igorpdsantos/alimentador-pet-iot/docs/estudos/chapeu/tabela_dem.md

| grão (mm) | variante | rodadas | ração (g) | carga no rotor/piso/escudo N (% do peso) | carga no chapéu N | torque mediano kgf·cm (faixa) | torque p90 | tempo acima de 1,8 kgf·cm | g/volta (faixa) |
|---|---|---|---|---|---|---|---|---|---|
| 10 | sem chapéu | 2 | 872 | 5.7 (67 %) | 0.0 | 2.91 (2.85–2.97) | 4.07 | 94 % | 47.8 (45.9–49.6) |
| 10 | cone Ø60 | 2 | 794 | 1.3 (17 %) | 4.6 | 0.40 (0.38–0.43) | 1.15 | 3 % | 43.2 (42.2–44.3) |
| 10 | cone Ø50 | 2 | 830 | 2.9 (36 %) | 2.9 | 1.62 (1.42–1.82) | 2.86 | 43 % | 48.3 (46.6–50.1) |
| 10 | telhado (aresta +5) | 2 | 708 | 1.1 (16 %) | 3.7 | 1.26 (1.23–1.29) | 2.13 | 23 % | 46.4 (45.5–47.4) |
| 10 | telhado (aresta +15) | 2 | 651 | 0.9 (13 %) | 4.3 | 0.93 (0.90–0.97) | 1.83 | 12 % | 44.7 (42.6–46.9) |
| 10 | telhado (aresta −10) | 2 | 793 | 3.0 (38 %) | 2.7 | 1.68 (1.60–1.76) | 2.66 | 46 % | 46.0 (44.5–47.6) |
| 10 | telhado baixo (11 mm) | 2 | 731 | 1.7 (24 %) | 3.7 | 0.72 (0.64–0.80) | 1.77 | 11 % | 44.2 (43.6–44.8) |
| 10 | telhado alto (40 mm) | 2 | 704 | 1.7 (25 %) | 3.4 | 1.36 (1.33–1.39) | 2.27 | 27 % | 47.2 (46.7–47.7) |
| 10 | bloco reto, aresta 25 mm | 2 | 707 | 1.6 (23 %) | 3.2 | 1.70 (1.59–1.82) | 2.81 | 46 % | 46.6 (44.9–48.3) |
| 10 | bloco reto, aresta 40 mm | 2 | 696 | 1.6 (24 %) | 3.5 | 2.04 (1.83–2.25) | 3.19 | 69 % | 46.6 (46.4–46.9) |
| 10 | P10 final: cumeeira 45°, aresta 40 mm | 2 | 700 | 1.6 (24 %) | 3.5 | 1.32 (1.24–1.40) | 2.16 | 22 % | 47.4 (46.9–47.9) |
| 20 | sem chapéu | 3 | 779 | 5.1 (67 %) | 0.0 | 2.63 (0.66–3.81) | 6.42 | 63 % | 12.7 (8.7–17.0) |
| 20 | cone Ø60 | 3 | 640 | 0.1 (2 %) | 5.4 | 0.00 (0.00–0.00) | 0.05 | 1 % | 3.5 (0.8–4.8) |
| 20 | cone Ø50 | 3 | 721 | 2.0 (28 %) | 4.0 | 2.64 (1.33–4.88) | 6.51 | 60 % | 17.5 (12.7–22.2) |
| 20 | telhado (aresta +5) | 3 | 622 | 1.9 (31 %) | 3.0 | 1.54 (1.38–1.65) | 5.11 | 46 % | 13.5 (10.0–15.2) |
| 20 | telhado (aresta +15) | 3 | 561 | 0.5 (8 %) | 4.6 | 0.44 (0.30–0.56) | 1.28 | 7 % | 6.4 (4.5–9.0) |
| 20 | telhado (aresta −10) | 3 | 699 | 3.0 (44 %) | 2.6 | 1.80 (1.67–1.91) | 5.42 | 51 % | 13.3 (10.4–14.8) |
| 20 | telhado baixo (11 mm) | 3 | 651 | 1.8 (28 %) | 3.2 | 0.36 (0.17–0.71) | 1.10 | 7 % | 7.9 (2.4–14.1) |
| 20 | telhado alto (40 mm) | 3 | 599 | 1.5 (25 %) | 3.3 | 1.16 (0.39–2.13) | 5.68 | 40 % | 19.3 (17.4–23.0) |
| 20 | bloco reto, aresta 25 mm | 4 | 634 | 1.7 (27 %) | 3.6 | 0.75 (0.19–1.86) | 2.25 | 21 % | 13.6 (7.5–21.0) |
| 20 | bloco reto, aresta 40 mm | 4 | 606 | 2.1 (36 %) | 3.4 | 1.49 (0.72–2.32) | 6.24 | 44 % | 21.8 (18.8–24.1) |
| 20 | P10 final: cumeeira 45°, aresta 40 mm | 4 | 605 | 2.1 (35 %) | 3.1 | 1.74 (0.88–2.72) | 5.08 | 47 % | 17.8 (12.5–25.7) |
| 20 | P10 aresta a 40 mm, +15 | 2 | 516 | 0.5 (10 %) | 4.1 | 0.69 (0.25–1.13) | 3.73 | 27 % | 8.4 (6.1–10.7) |
