igorpdsantos/alimentador-pet-iot/cad/historico/v2/renders/v2/corte_X0.png

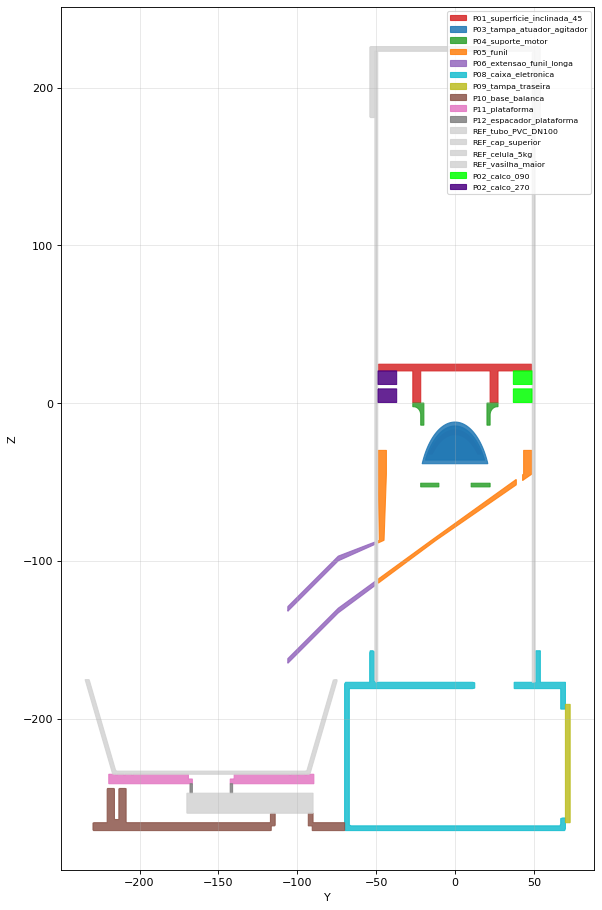
cad/historico/v2/renders/v2/corte_X0.png
