igorpdsantos/alimentador-pet-iot/cad/historico/v2/renders/v2/corte_Y0.png

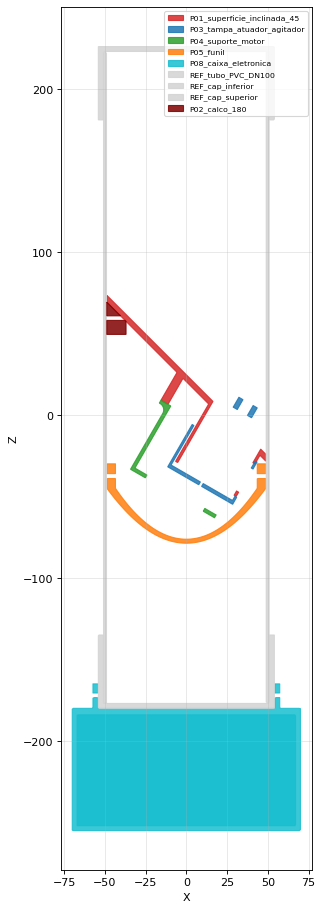
cad/historico/v2/renders/v2/corte_Y0.png
