igorpdsantos/alimentador-pet-iot/cad/historico/v2/renders/v2/render_iso.png

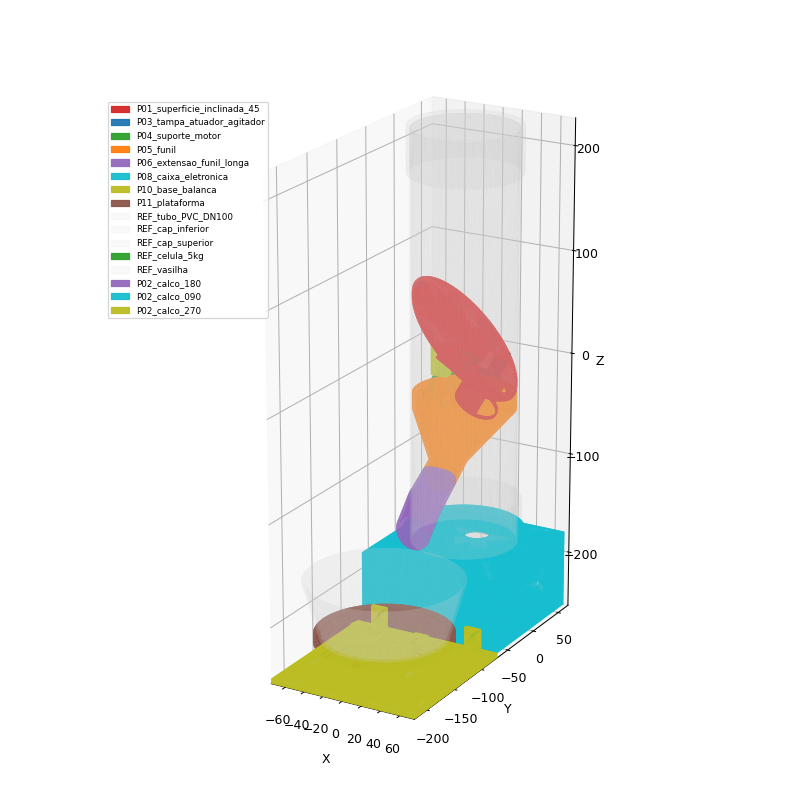
cad/historico/v2/renders/v2/render_iso.png
