igorpdsantos/alimentador-pet-iot/cad/historico/v2/renders/v2/render_side.png

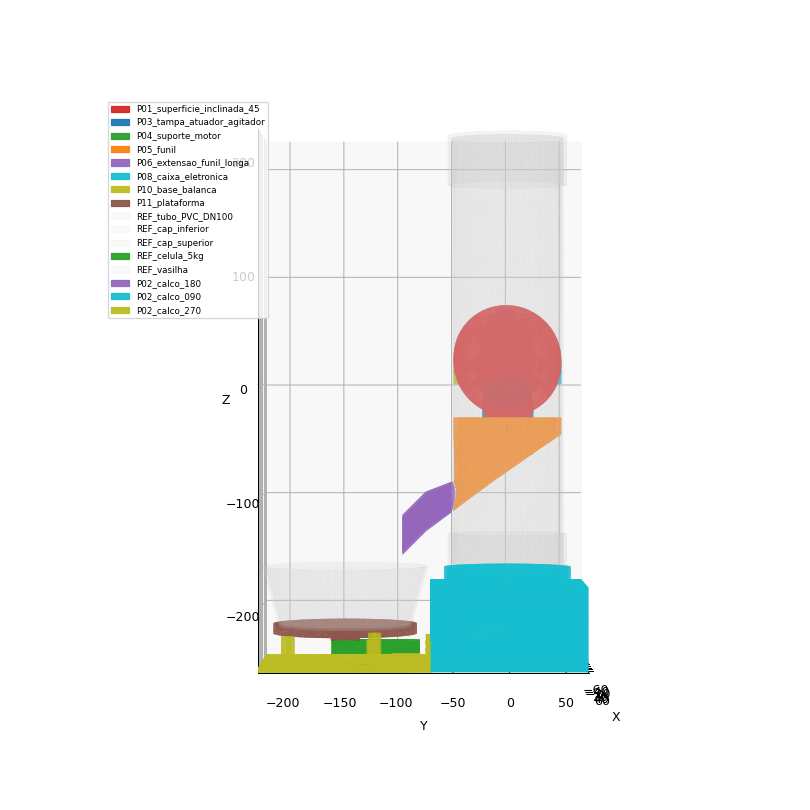
cad/historico/v2/renders/v2/render_side.png
