igorpdsantos/alimentador-pet-iot/cad/historico/v2/renders/v2_mecanismo/render_side.png

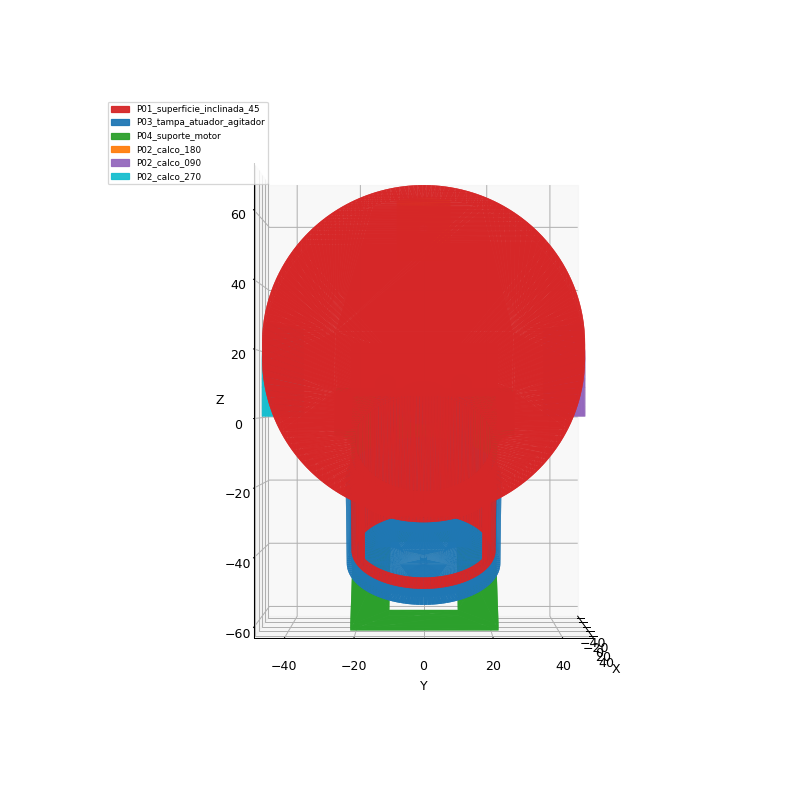
cad/historico/v2/renders/v2_mecanismo/render_side.png
