igorpdsantos/alimentador-pet-iot/cad/historico/v2/renders/v2_tampa/render_iso.png

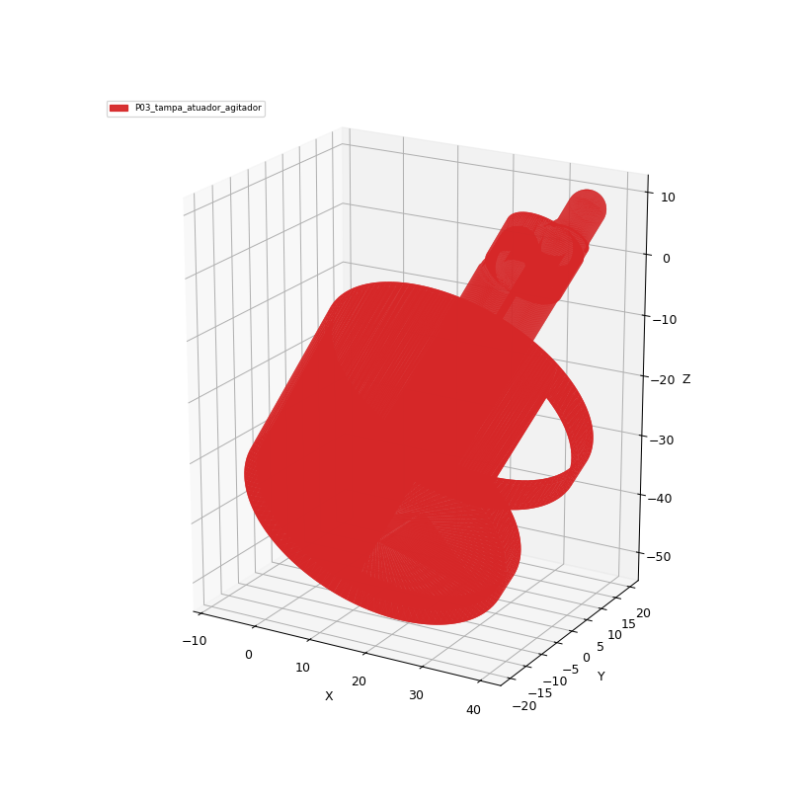
cad/historico/v2/renders/v2_tampa/render_iso.png
