igorpdsantos/alimentador-pet-iot/cad/renders/v3/chapeu/corte_Y0.png

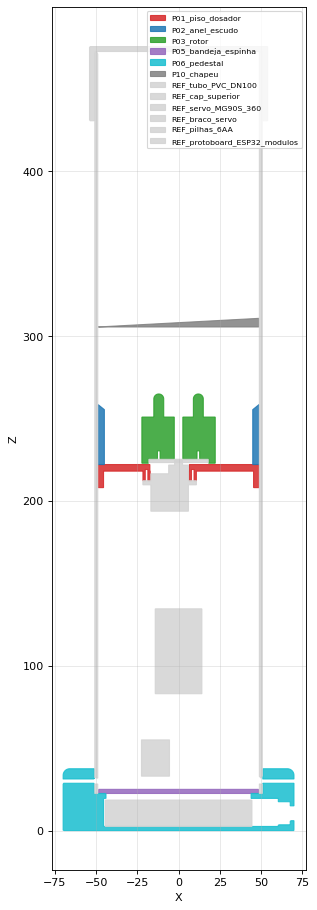
cad/renders/v3/chapeu/corte_Y0.png
