igorpdsantos/alimentador-pet-iot/cad/renders/v3/chapeu/render_iso.png

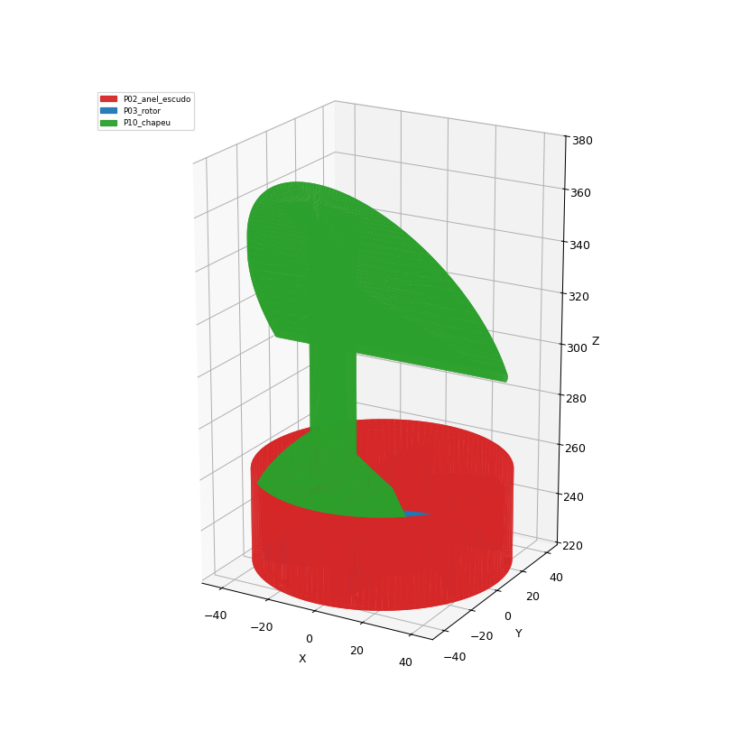
cad/renders/v3/chapeu/render_iso.png
