igorpdsantos/alimentador-pet-iot/cad/renders/v3/chapeu/render_top.png

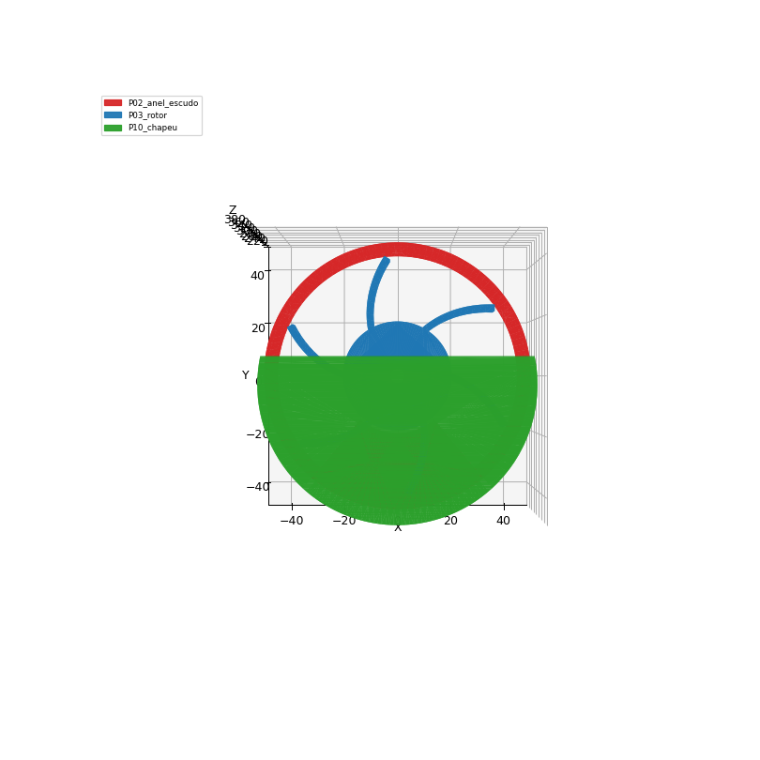
cad/renders/v3/chapeu/render_top.png
