igorpdsantos/alimentador-pet-iot/cad/renders/v3/corte_X0.png

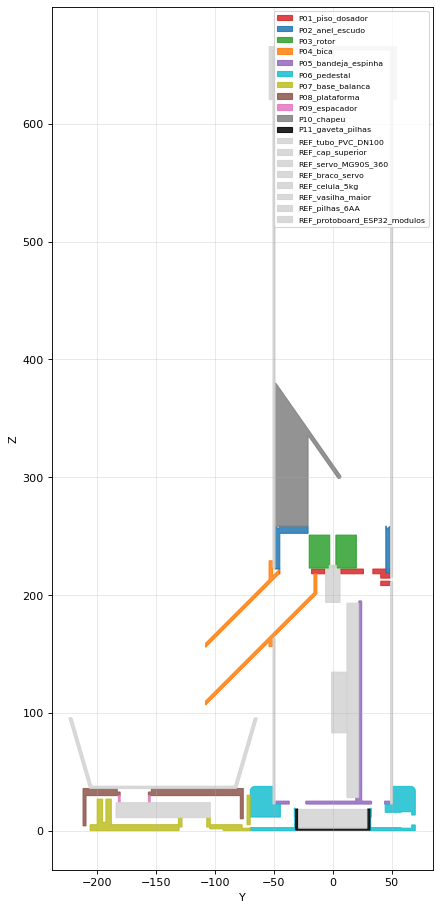
cad/renders/v3/corte_X0.png
