igorpdsantos/alimentador-pet-iot/cad/renders/v3/gaveta/ped/render_iso.png

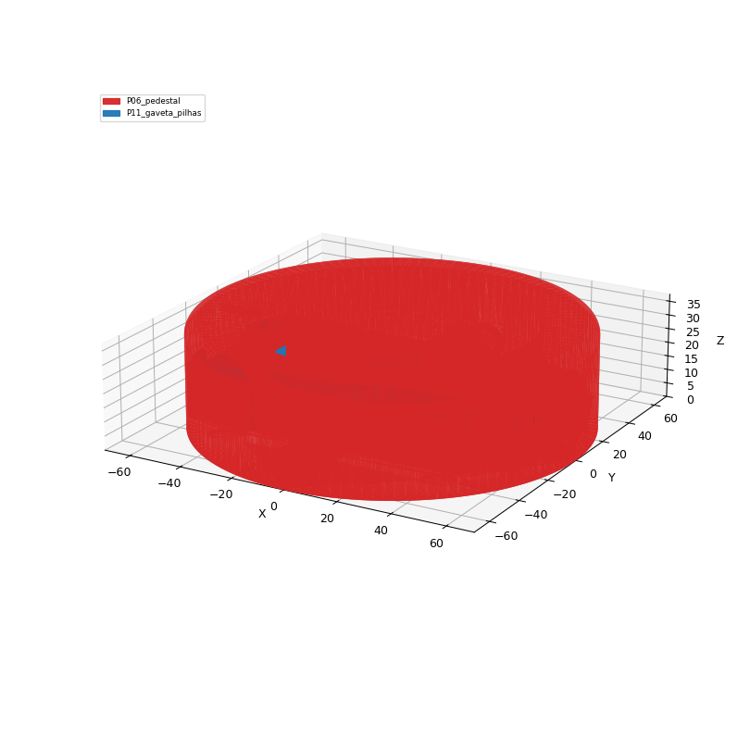
cad/renders/v3/gaveta/ped/render_iso.png
