igorpdsantos/alimentador-pet-iot/cad/renders/v3/gaveta/render_top.png

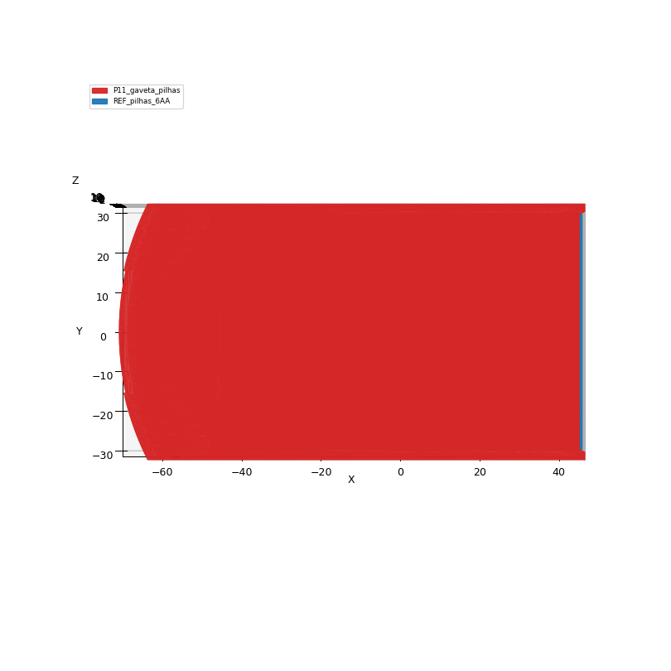
cad/renders/v3/gaveta/render_top.png
