igorpdsantos/alimentador-pet-iot/cad/renders/v3/render_front.png

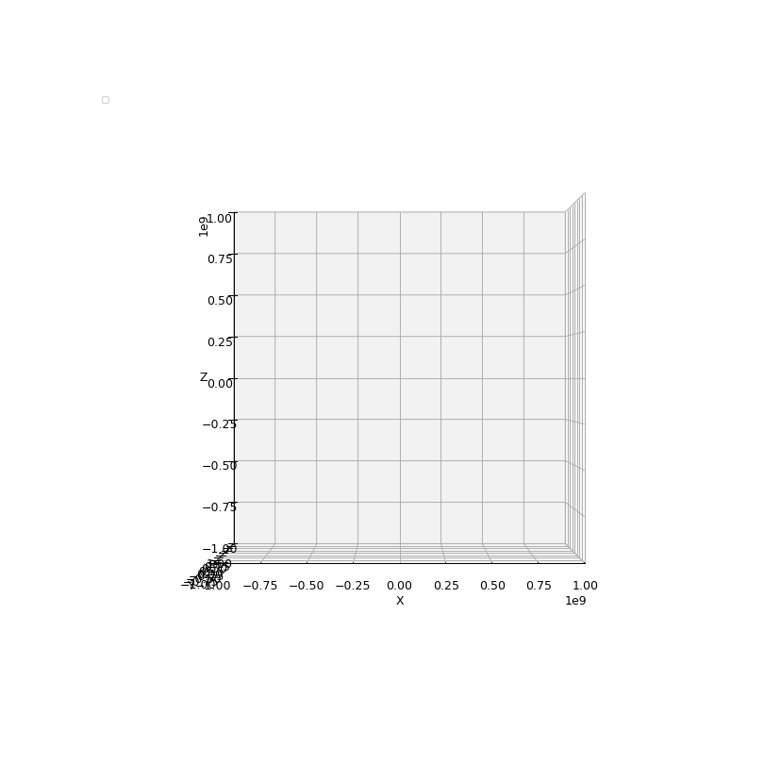
cad/renders/v3/render_front.png
