igorpdsantos/alimentador-pet-iot/cad/renders/v3/render_iso.png

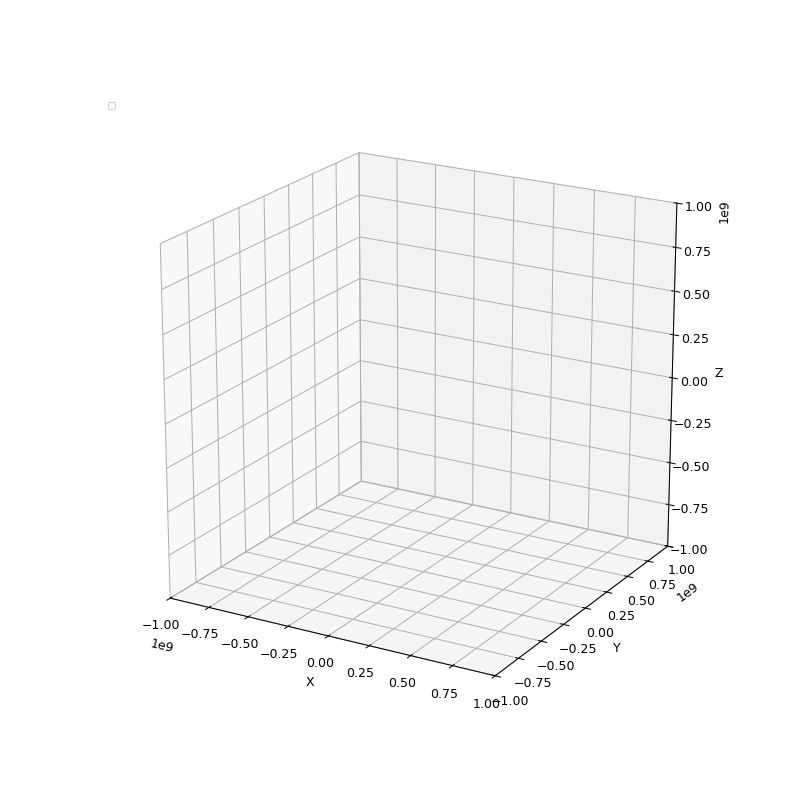
cad/renders/v3/render_iso.png
