igorpdsantos/alimentador-pet-iot/cad/renders/v3/render_side.png

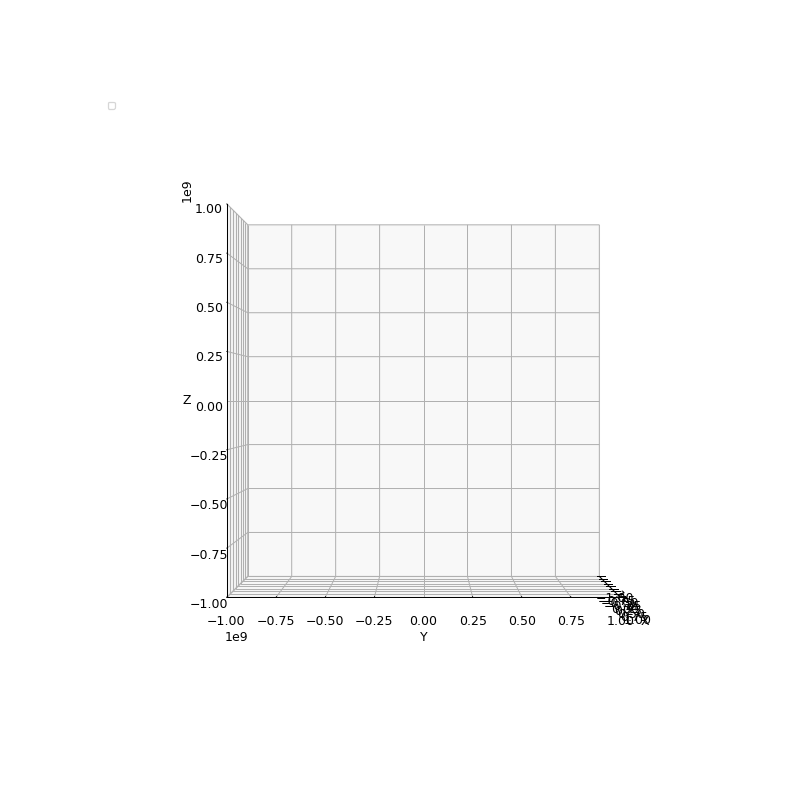
cad/renders/v3/render_side.png
