igorpdsantos/alimentador-pet-iot/cad/renders/v3/render_top.png

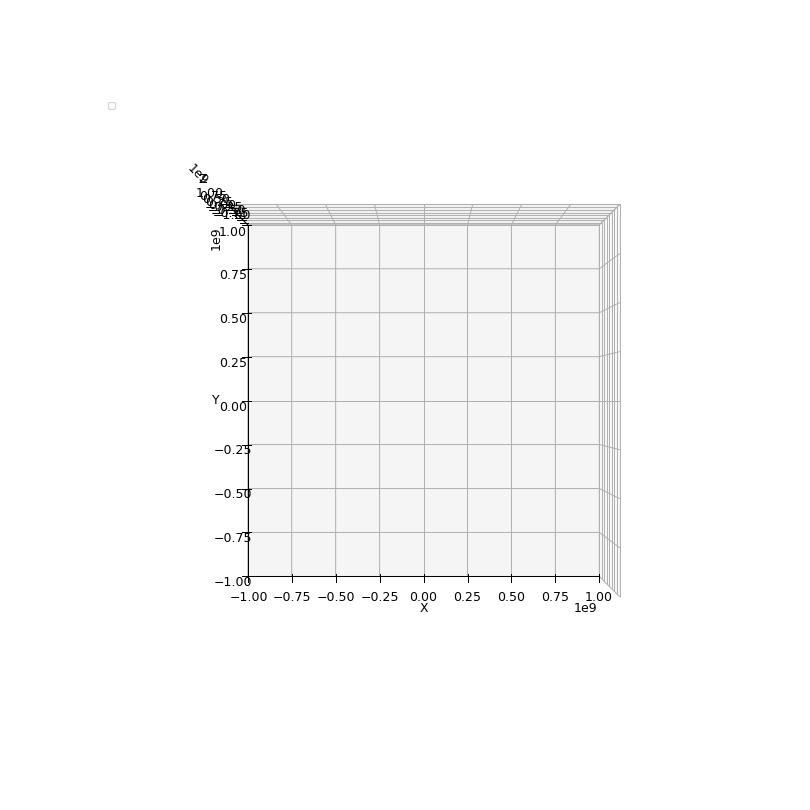
cad/renders/v3/render_top.png
