igorpdsantos/alimentador-pet-iot/docs/estudos/chapeu/dem_comparacao.png

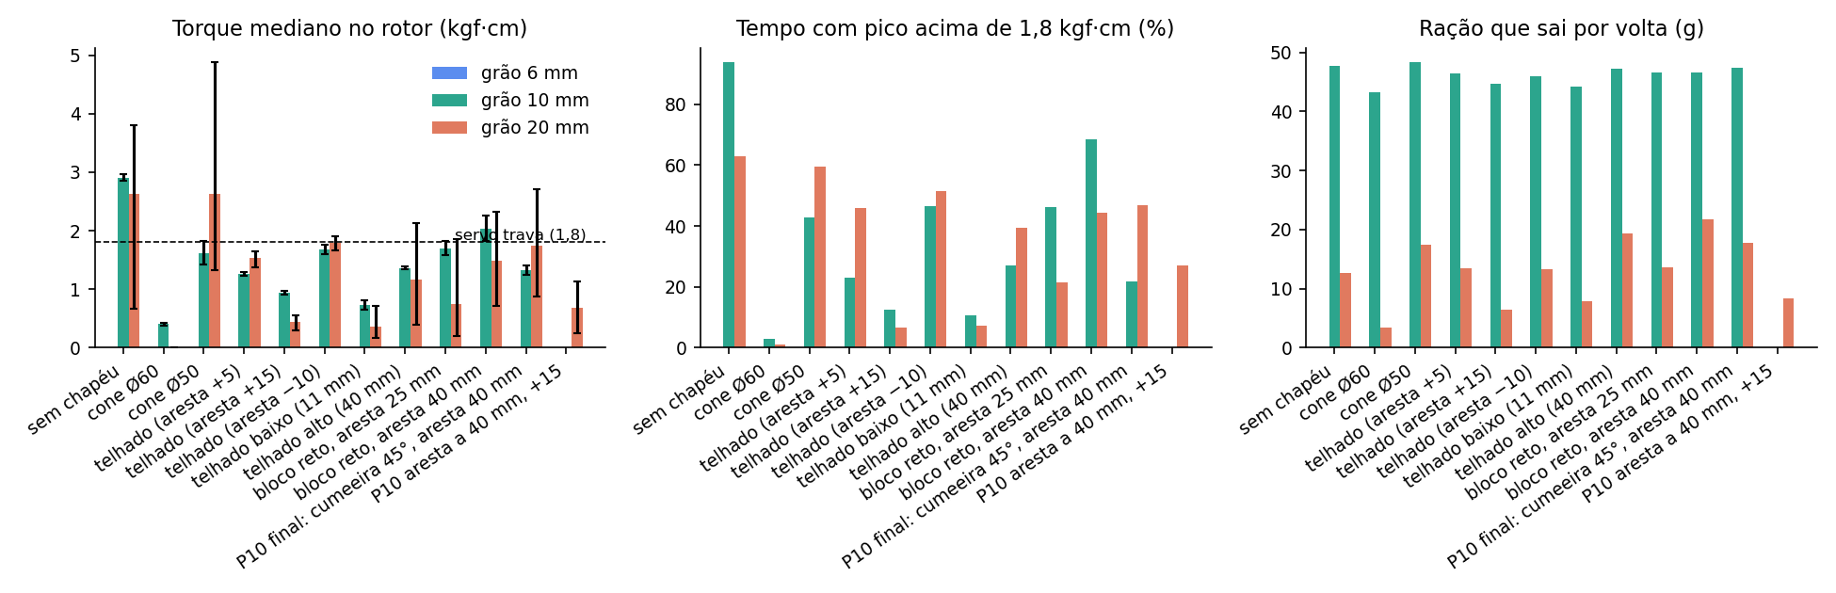
docs/estudos/chapeu/dem_comparacao.png
