igorpdsantos/alimentador-pet-iot/docs/estudos/chapeu/dem_serie_10mm.png

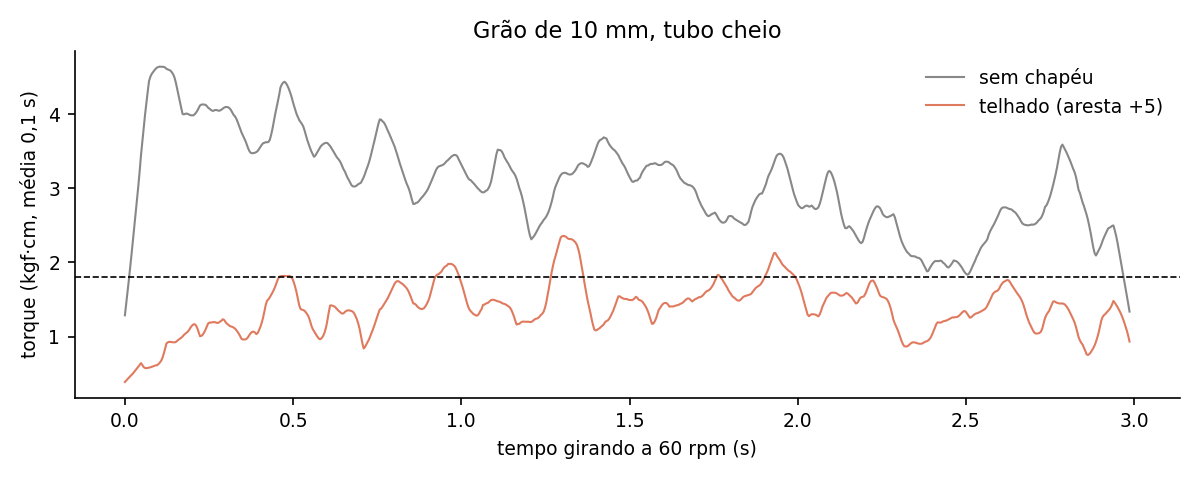
docs/estudos/chapeu/dem_serie_10mm.png
