igorpdsantos/alimentador-pet-iot/docs/imagens/01_geral.png

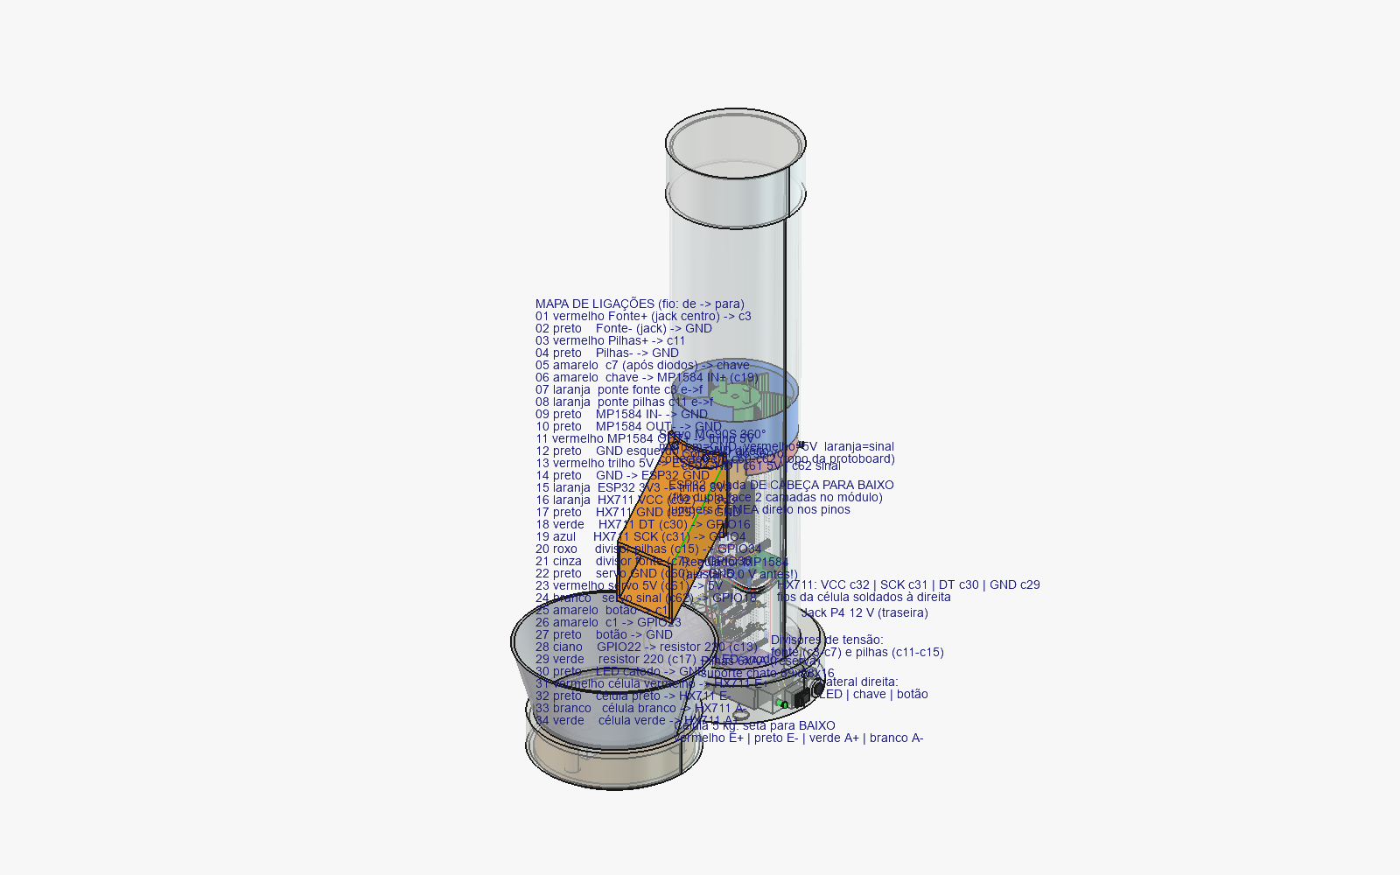
docs/imagens/01_geral.png
