igorpdsantos/alimentador-pet-iot/docs/imagens/02_protoboard_frente.png

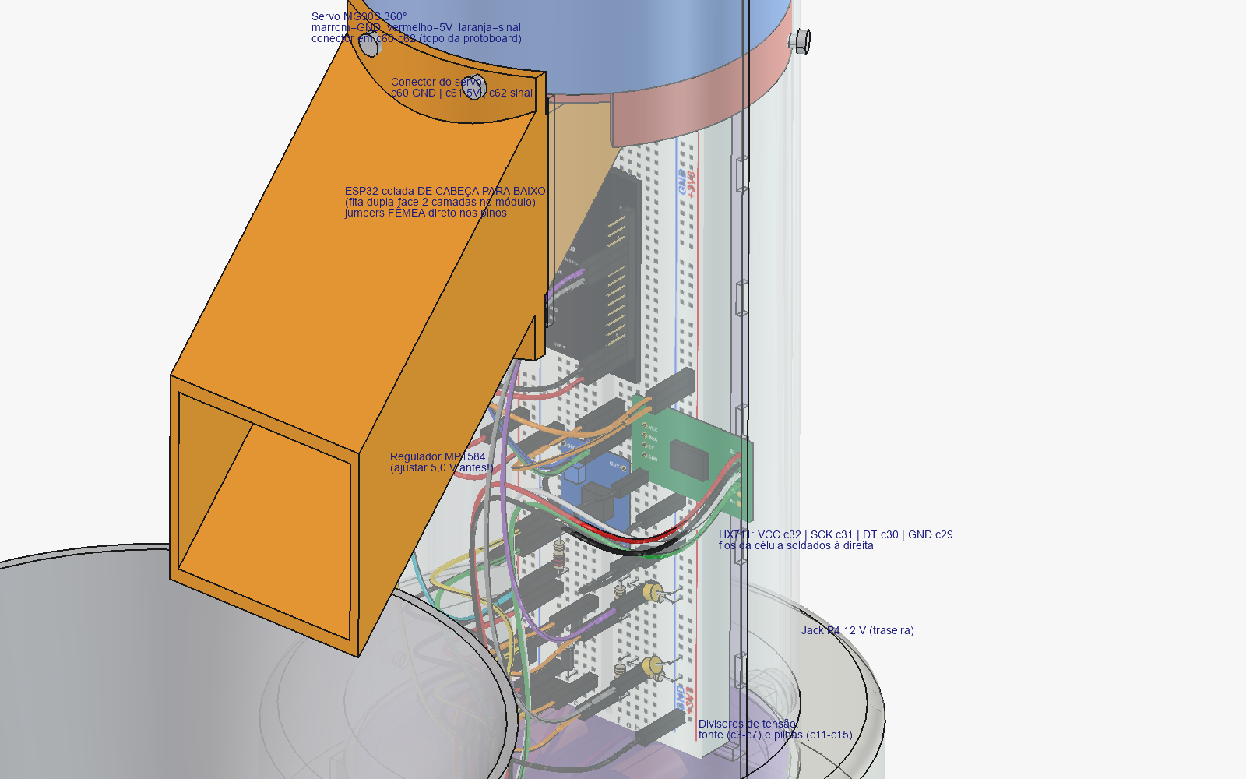
docs/imagens/02_protoboard_frente.png
