igorpdsantos/alimentador-pet-iot/docs/imagens/03_esp32_pinos.png

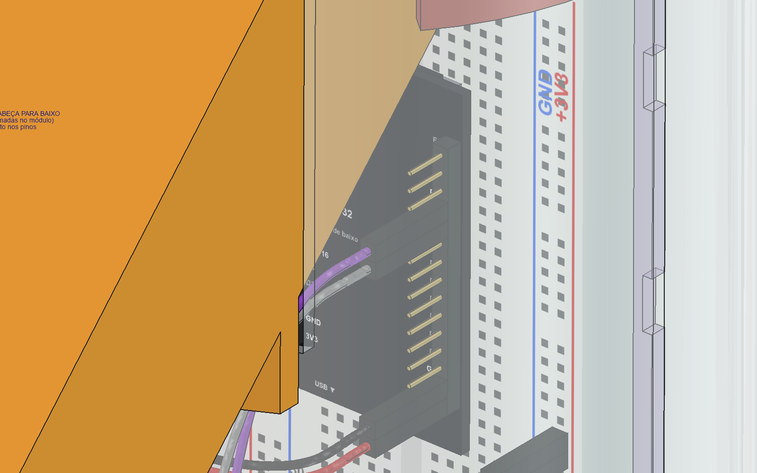
docs/imagens/03_esp32_pinos.png
