igorpdsantos/alimentador-pet-iot/docs/imagens/04_pedestal.png

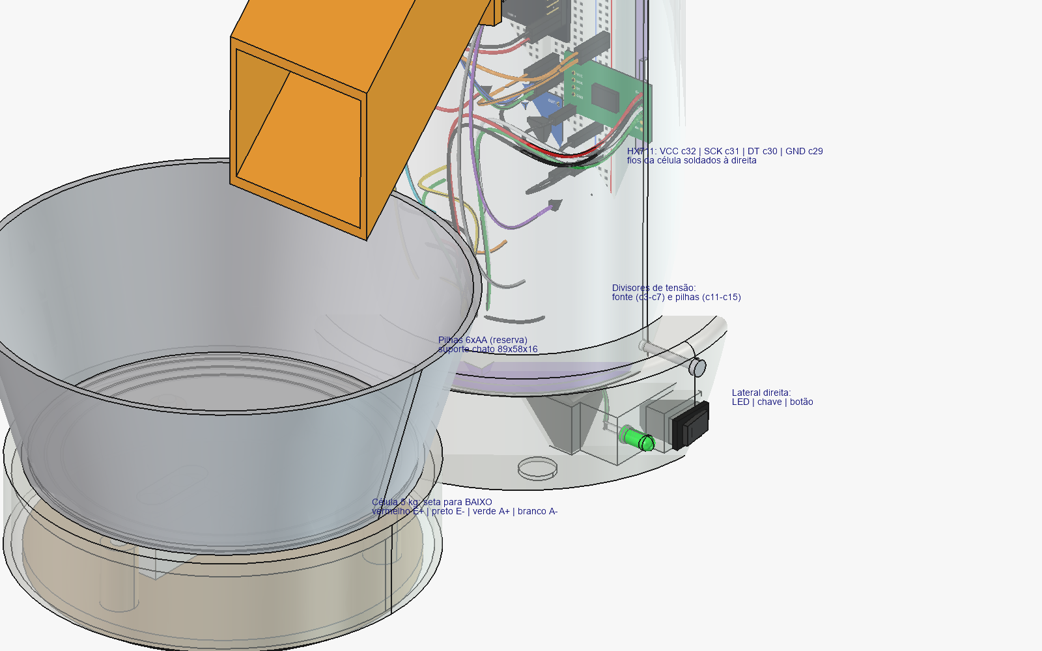
docs/imagens/04_pedestal.png
