igorpdsantos/alimentador-pet-iot/docs/imagens/05_balanca.png

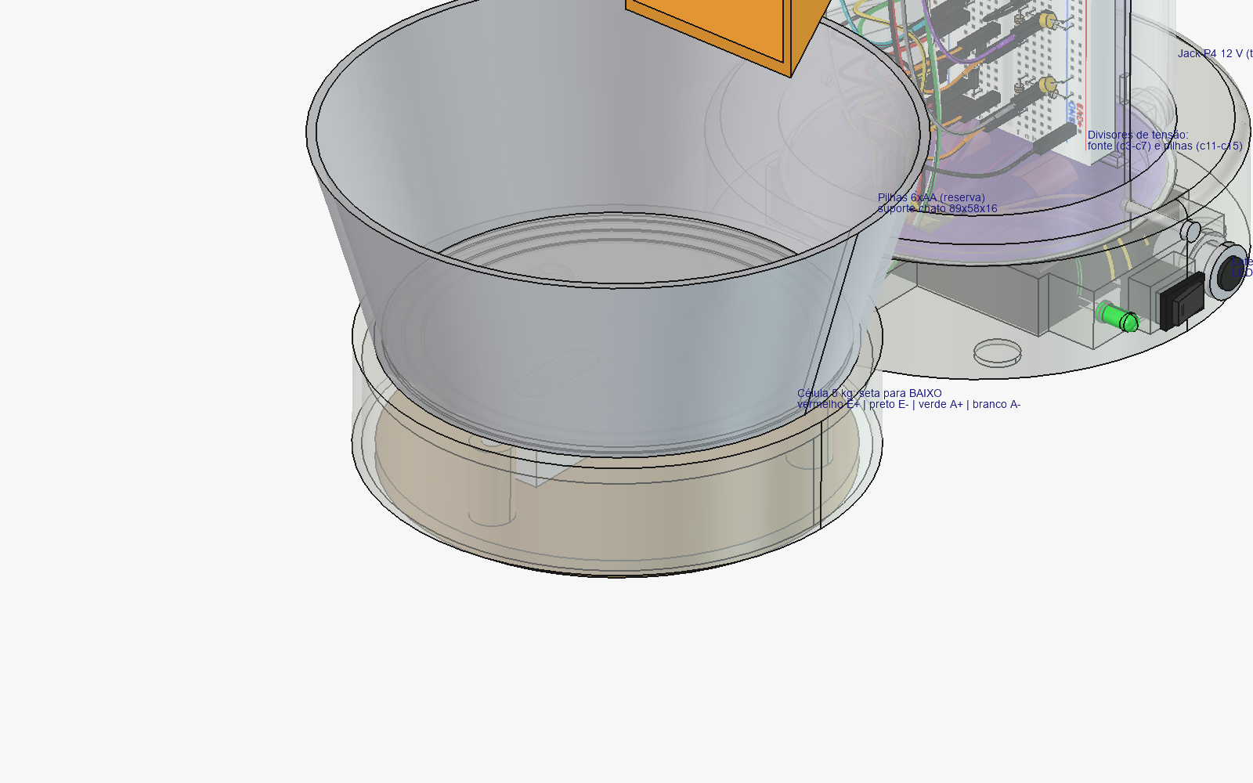
docs/imagens/05_balanca.png
