igorpdsantos/alimentador-pet-iot/docs/imagens/06_servo_cartucho.png

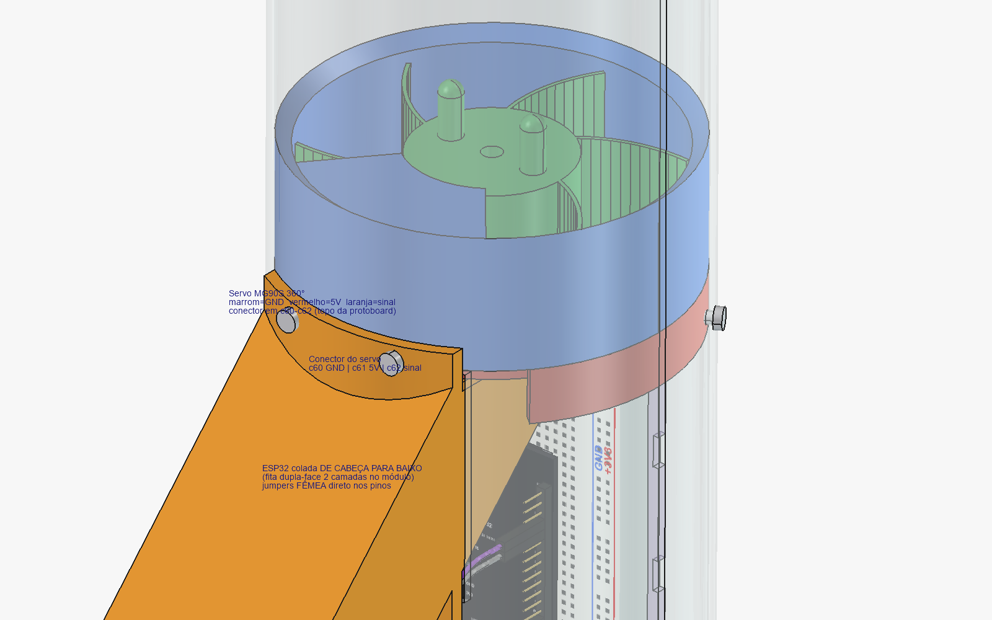
docs/imagens/06_servo_cartucho.png
