igorpdsantos/alimentador-pet-iot/site/img/balanca.png

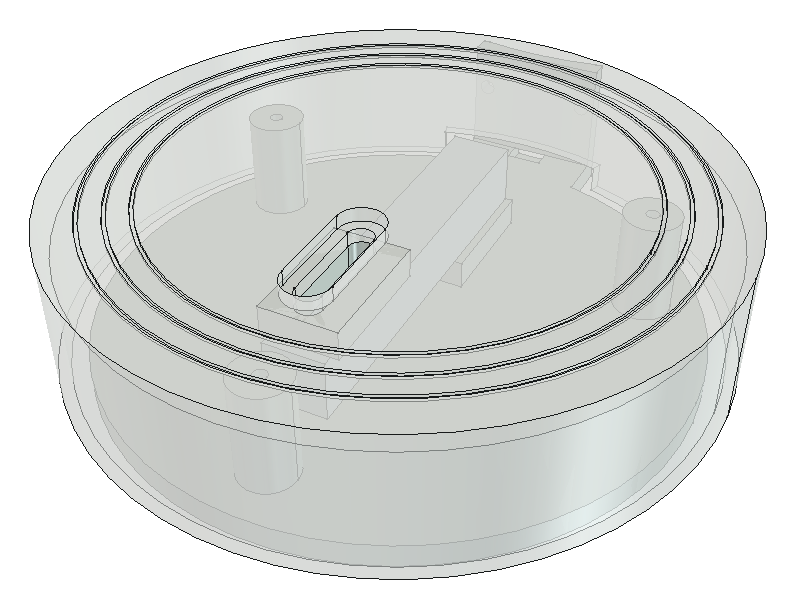
site/img/balanca.png
