igorpdsantos/alimentador-pet-iot/site/img/cartucho.png

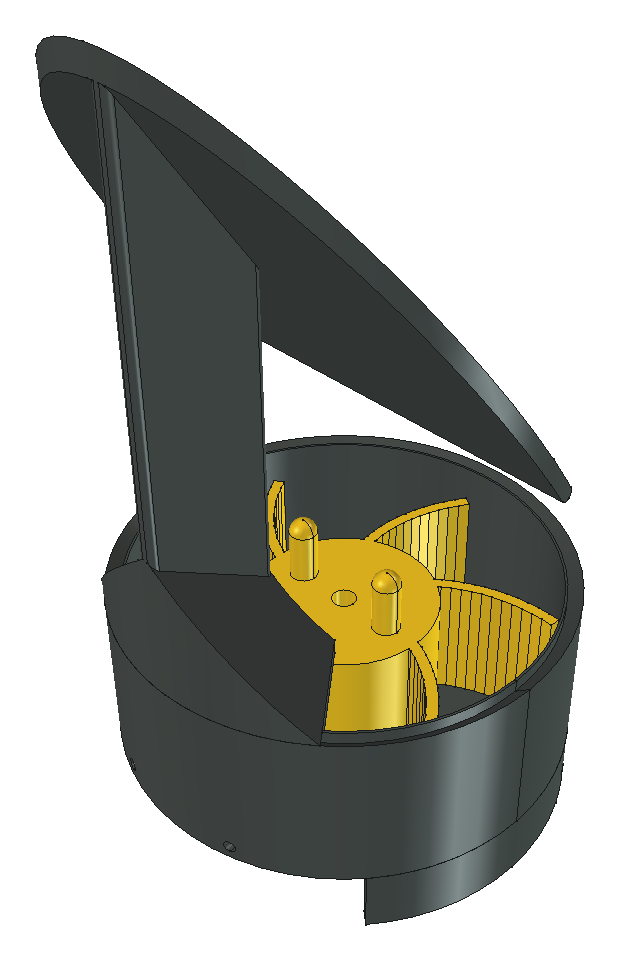
site/img/cartucho.png
