igorpdsantos/alimentador-pet-iot/site/img/comp/botao.png

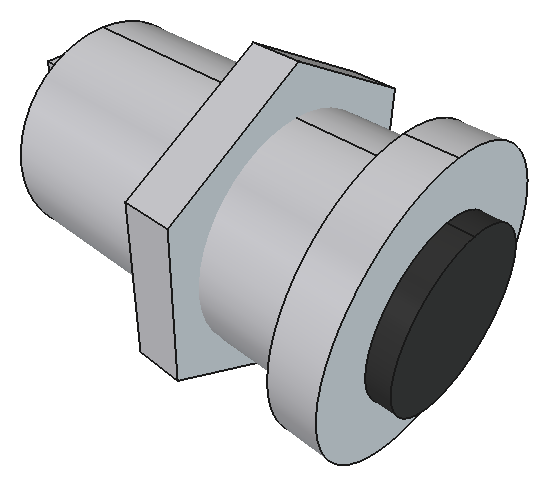
site/img/comp/botao.png
