igorpdsantos/alimentador-pet-iot/site/img/comp/cap.png

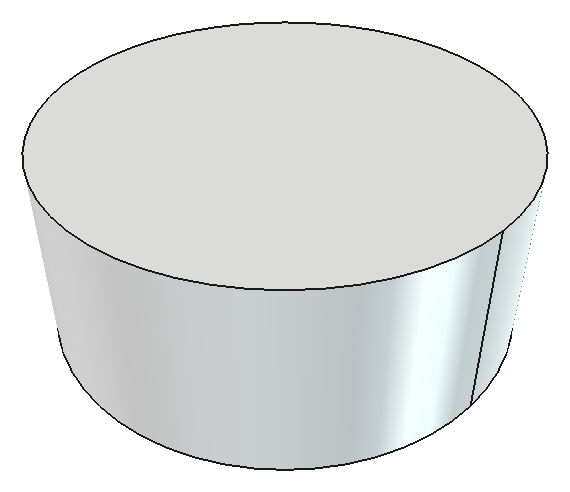
site/img/comp/cap.png
