igorpdsantos/alimentador-pet-iot/site/img/comp/cap_ceramico.png

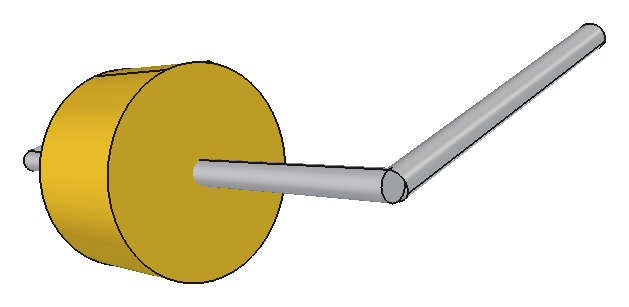
site/img/comp/cap_ceramico.png
