igorpdsantos/alimentador-pet-iot/site/img/comp/cap_eletrolitico.png

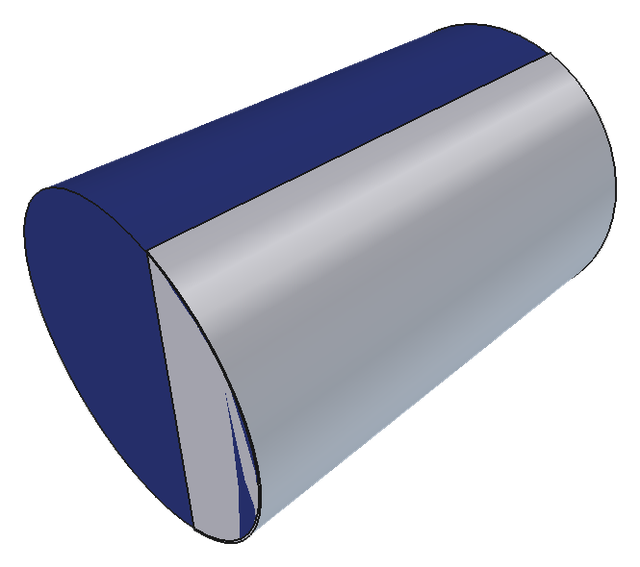
site/img/comp/cap_eletrolitico.png
