igorpdsantos/alimentador-pet-iot/site/img/comp/celula.png

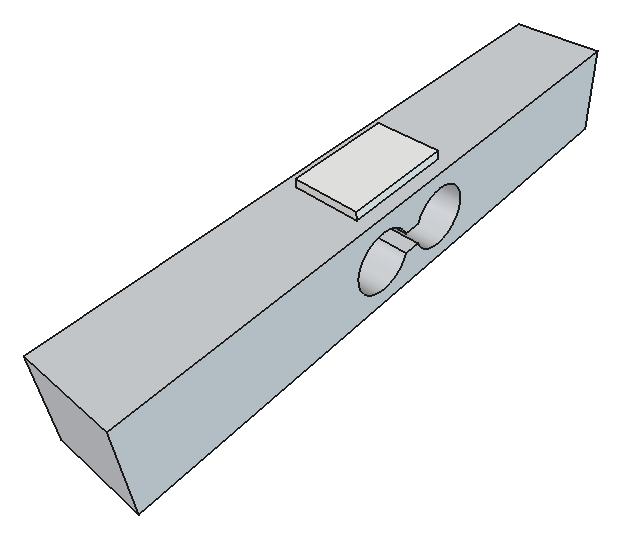
site/img/comp/celula.png
