igorpdsantos/alimentador-pet-iot/site/img/comp/chave.png

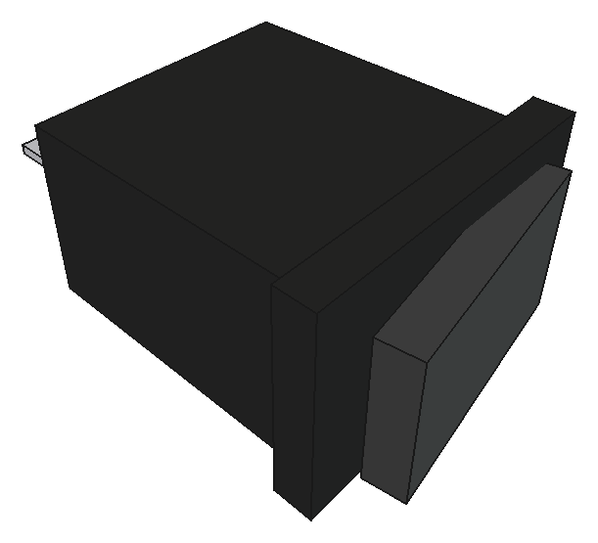
site/img/comp/chave.png
