igorpdsantos/alimentador-pet-iot/site/img/comp/diodo.png

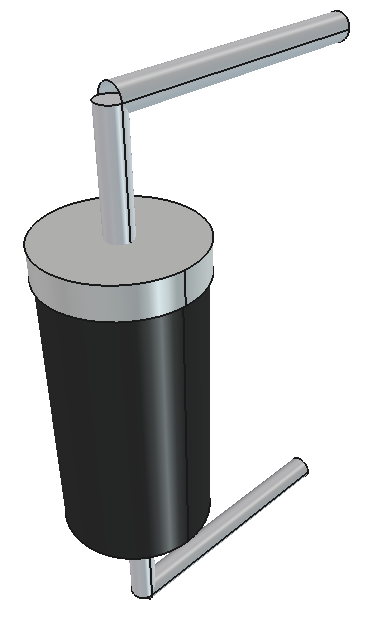
site/img/comp/diodo.png
