igorpdsantos/alimentador-pet-iot/site/img/comp/esp32.png

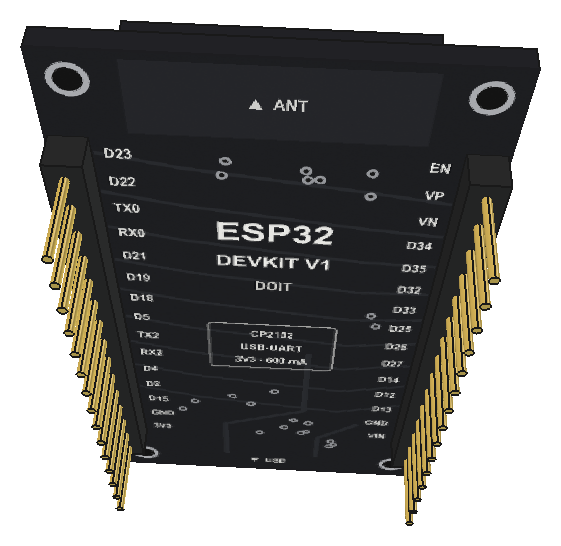
site/img/comp/esp32.png
