igorpdsantos/alimentador-pet-iot/site/img/comp/hx711.png

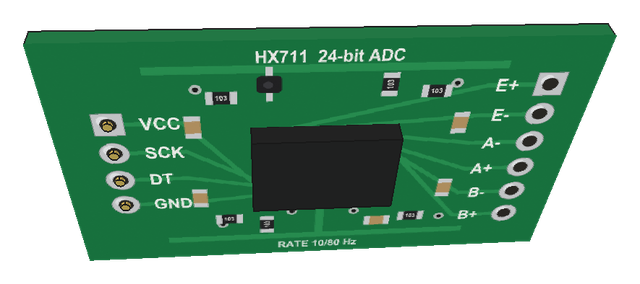
site/img/comp/hx711.png
