igorpdsantos/alimentador-pet-iot/site/img/comp/imas.png

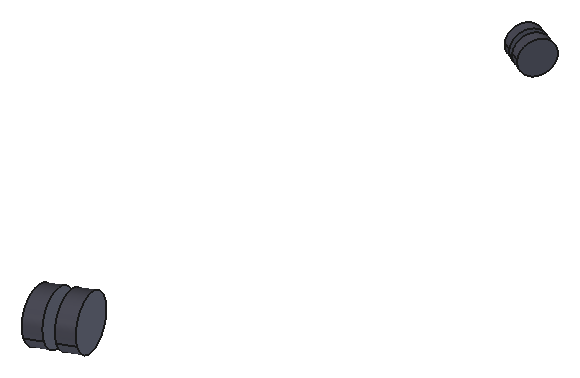
site/img/comp/imas.png
