igorpdsantos/alimentador-pet-iot/site/img/comp/jack.png

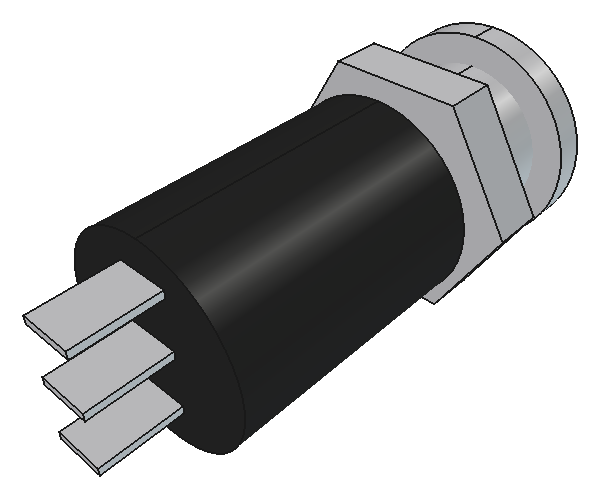
site/img/comp/jack.png
