igorpdsantos/alimentador-pet-iot/site/img/comp/led.png

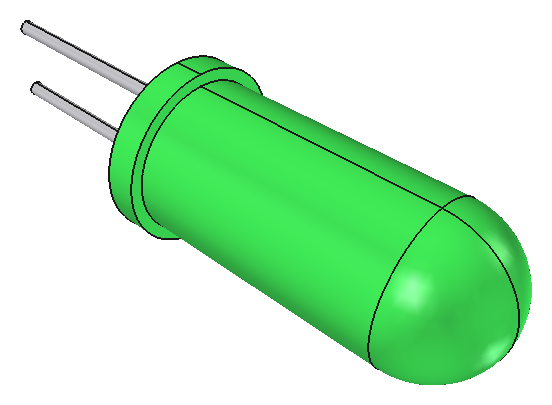
site/img/comp/led.png
