igorpdsantos/alimentador-pet-iot/site/img/comp/m3x8.png

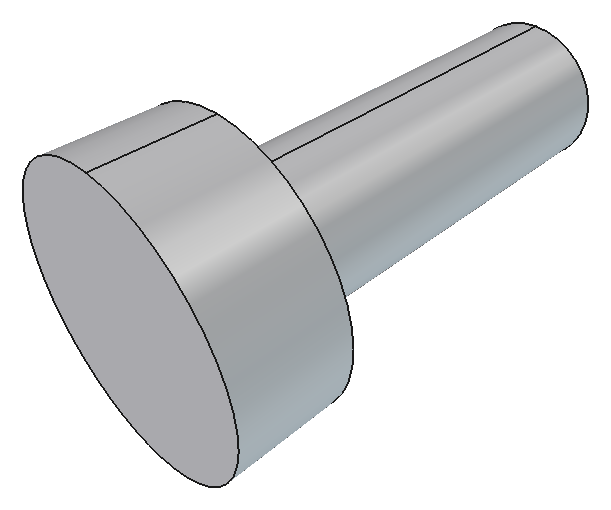
site/img/comp/m3x8.png
