igorpdsantos/alimentador-pet-iot/site/img/comp/m3x10.png

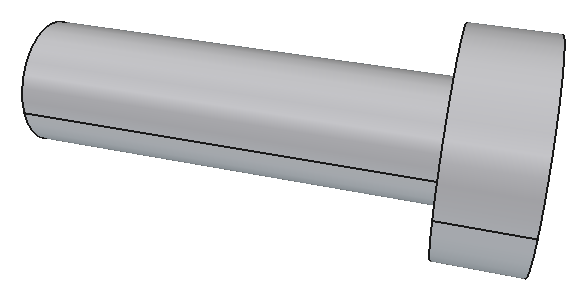
site/img/comp/m3x10.png
