igorpdsantos/alimentador-pet-iot/site/img/comp/m3x12.png

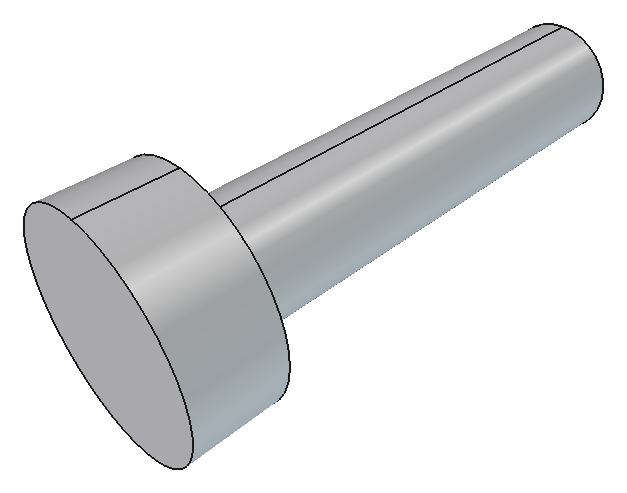
site/img/comp/m3x12.png
