igorpdsantos/alimentador-pet-iot/site/img/comp/m3x20.png

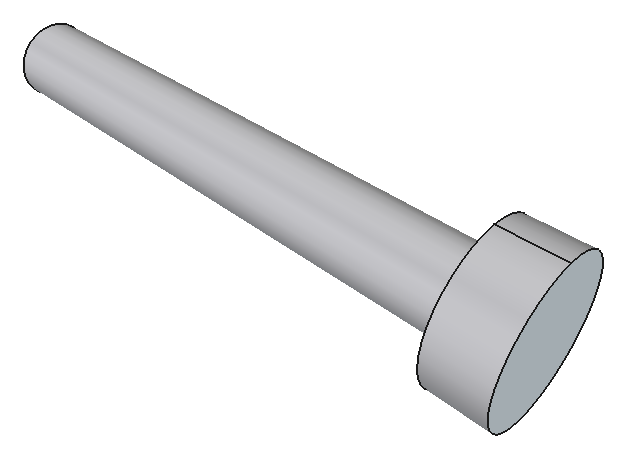
site/img/comp/m3x20.png
