igorpdsantos/alimentador-pet-iot/site/img/comp/m4x16.png

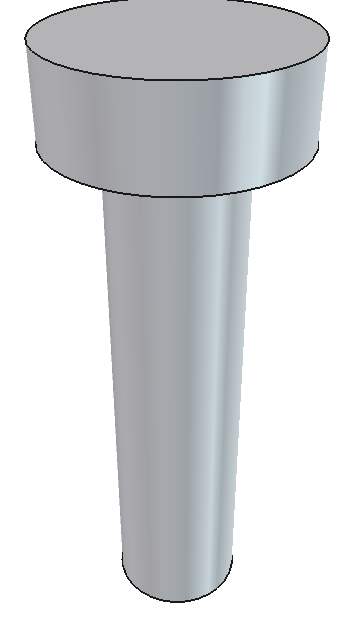
site/img/comp/m4x16.png
