igorpdsantos/alimentador-pet-iot/site/img/comp/m5x16.png

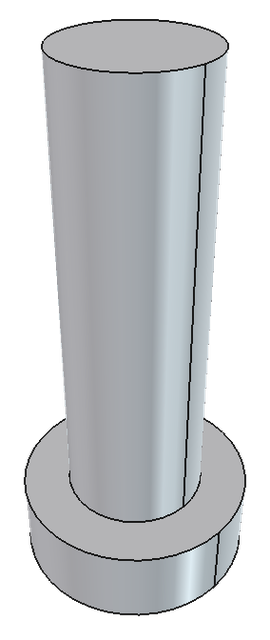
site/img/comp/m5x16.png
