igorpdsantos/alimentador-pet-iot/site/img/comp/mp1584.png

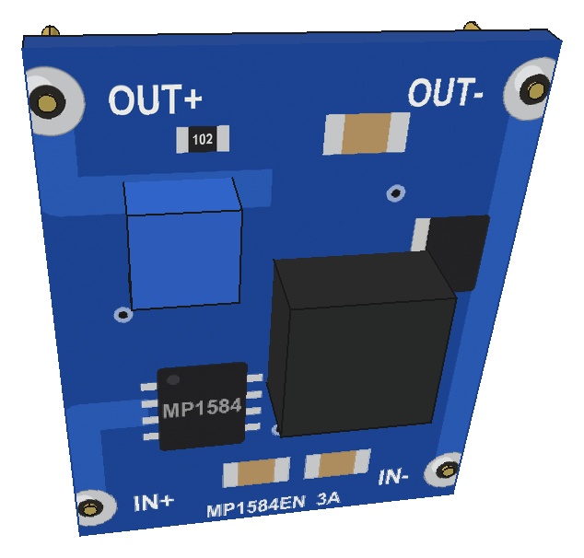
site/img/comp/mp1584.png
