igorpdsantos/alimentador-pet-iot/site/img/comp/pilhas.png

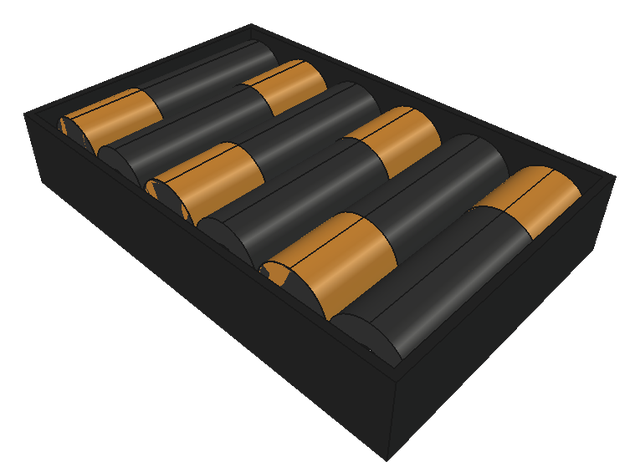
site/img/comp/pilhas.png
