igorpdsantos/alimentador-pet-iot/site/img/comp/protoboard.png

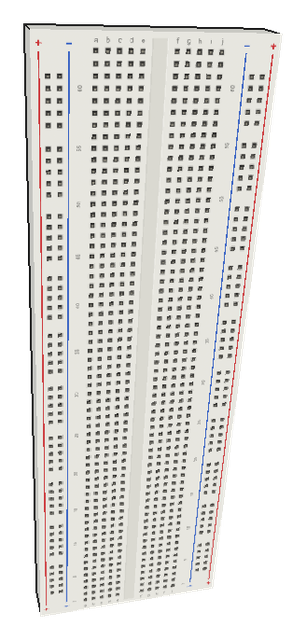
site/img/comp/protoboard.png
