igorpdsantos/alimentador-pet-iot/site/img/comp/resistor.png

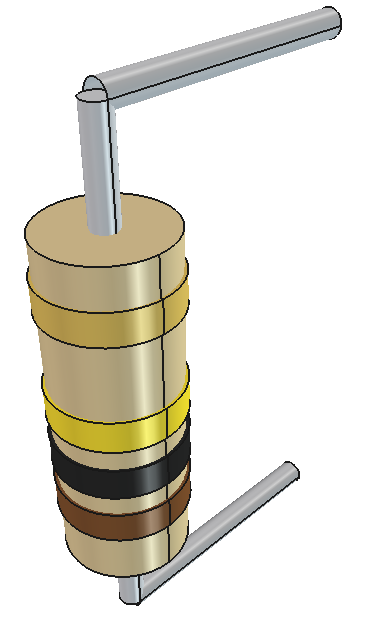
site/img/comp/resistor.png
