igorpdsantos/alimentador-pet-iot/site/img/comp/servo.png

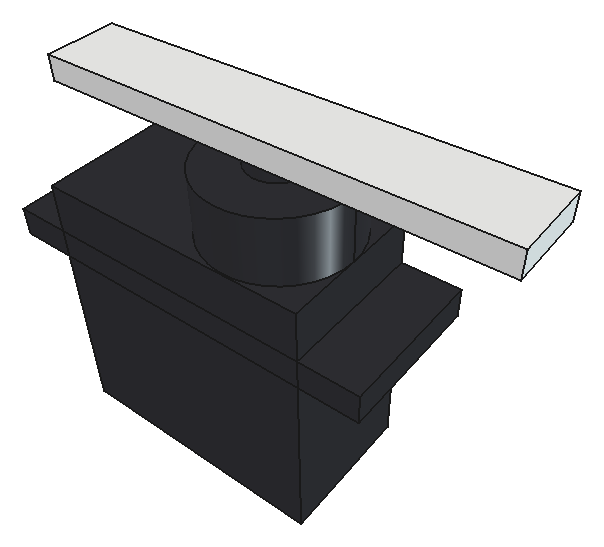
site/img/comp/servo.png
