igorpdsantos/alimentador-pet-iot/site/img/comp/tubo.png

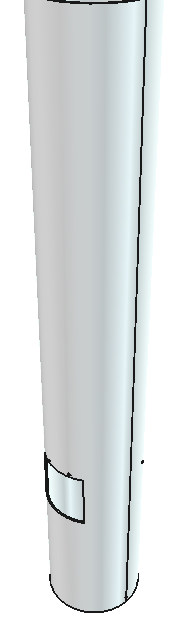
site/img/comp/tubo.png
