igorpdsantos/alimentador-pet-iot/site/img/comp/vasilha.png

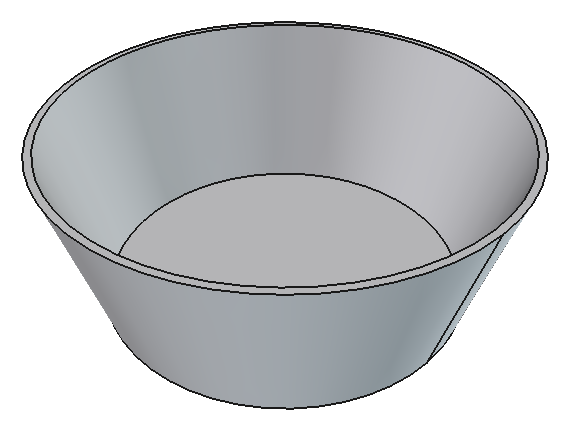
site/img/comp/vasilha.png
