igorpdsantos/alimentador-pet-iot/site/img/eletronica.png

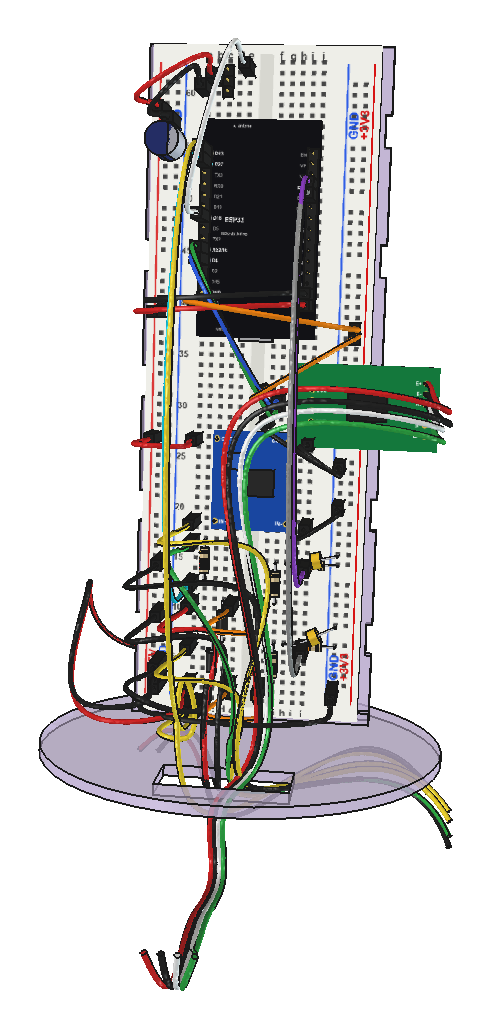
site/img/eletronica.png
