igorpdsantos/alimentador-pet-iot/site/img/pecas/P01_piso_dosador.png

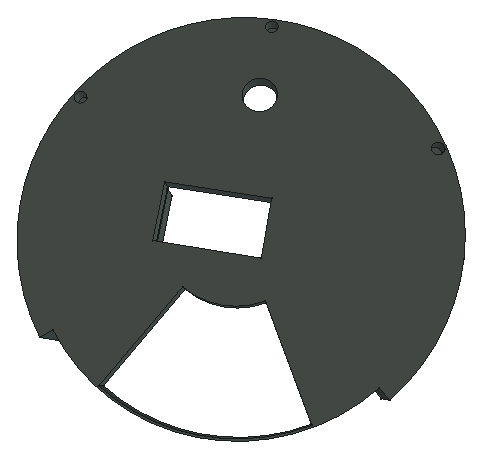
site/img/pecas/P01_piso_dosador.png
