igorpdsantos/alimentador-pet-iot/site/img/pecas/P02_anel_escudo.png

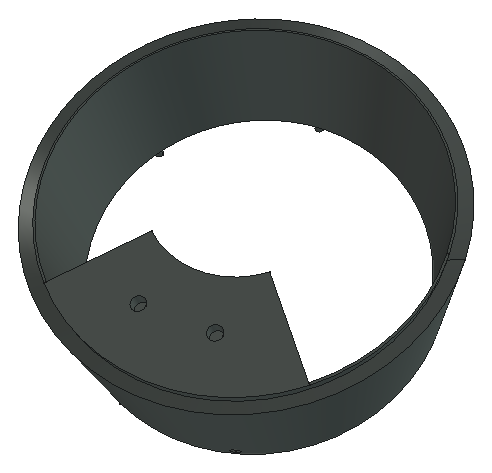
site/img/pecas/P02_anel_escudo.png
