igorpdsantos/alimentador-pet-iot/site/img/pecas/P03_rotor.png

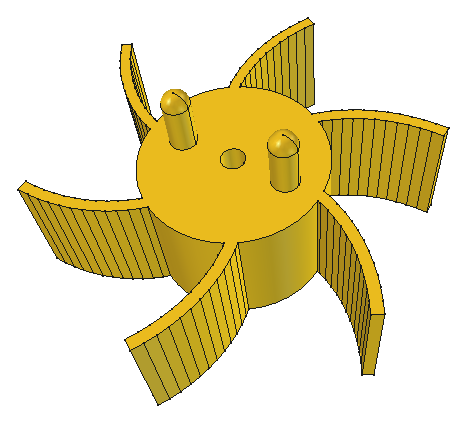
site/img/pecas/P03_rotor.png
