igorpdsantos/alimentador-pet-iot/site/img/pecas/P04_bica.png

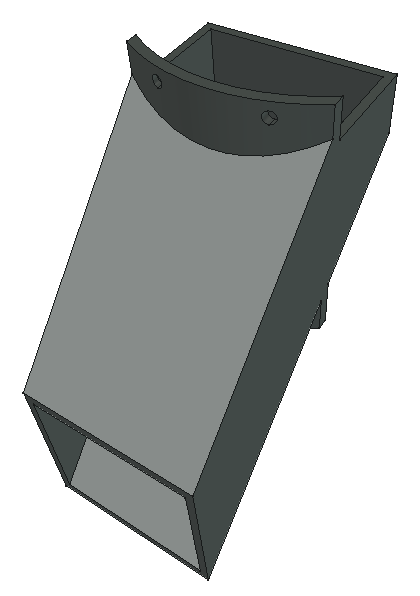
site/img/pecas/P04_bica.png
