igorpdsantos/alimentador-pet-iot/site/img/pecas/P05_bandeja_espinha.png

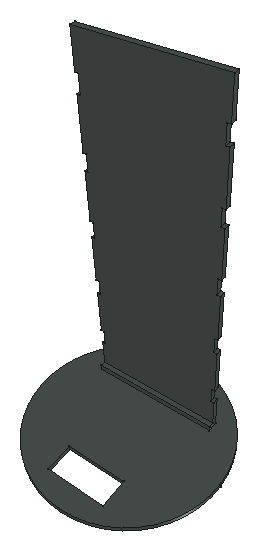
site/img/pecas/P05_bandeja_espinha.png
