igorpdsantos/alimentador-pet-iot/site/img/pecas/P06_pedestal.png

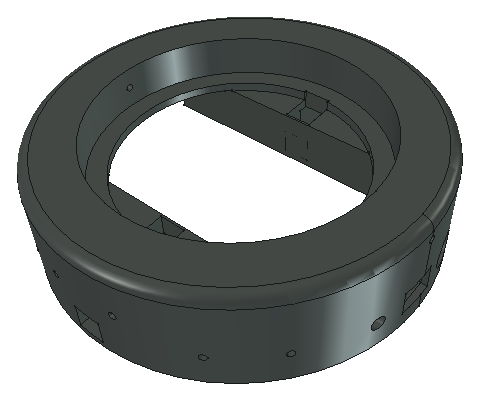
site/img/pecas/P06_pedestal.png
