igorpdsantos/alimentador-pet-iot/site/img/pecas/P07_base_balanca.png

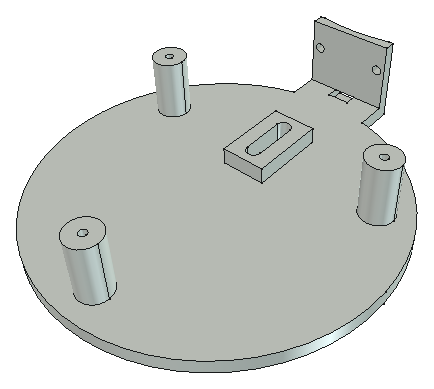
site/img/pecas/P07_base_balanca.png
