igorpdsantos/alimentador-pet-iot/site/img/pecas/P08_plataforma.png

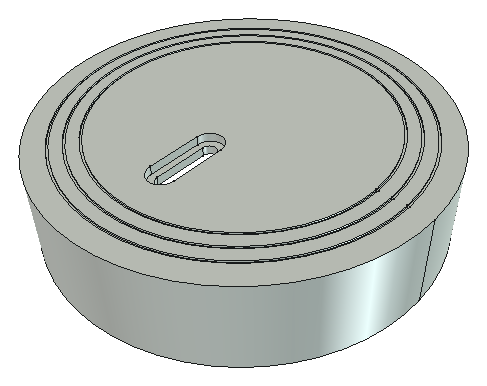
site/img/pecas/P08_plataforma.png
