igorpdsantos/alimentador-pet-iot/site/img/pecas/P09_espacador.png

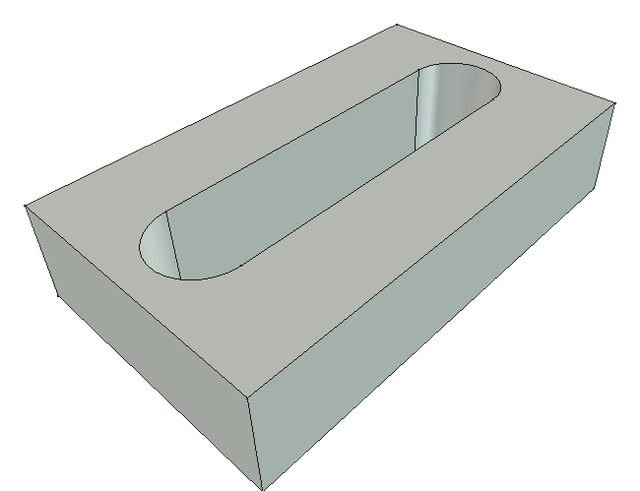
site/img/pecas/P09_espacador.png
