igorpdsantos/alimentador-pet-iot/site/img/pecas/P10_chapeu.png

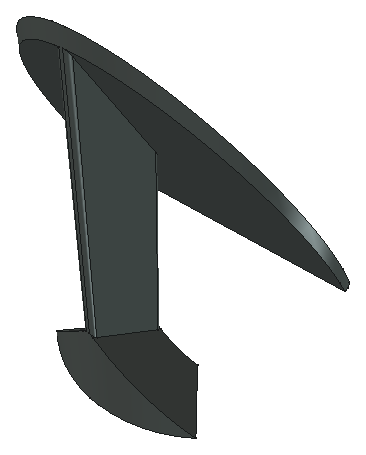
site/img/pecas/P10_chapeu.png
