igorpdsantos/alimentador-pet-iot/site/img/pecas/P11_gaveta_pilhas.png

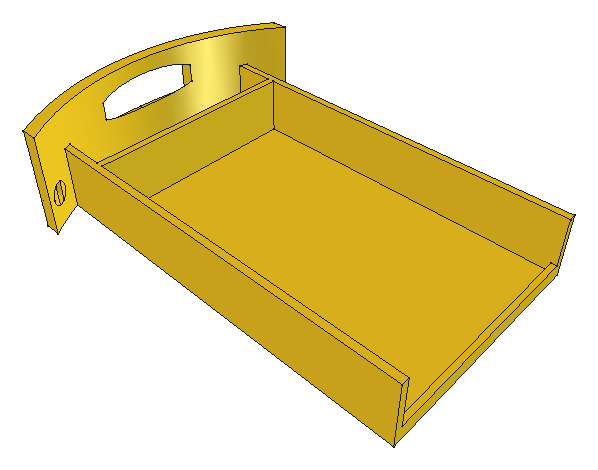
site/img/pecas/P11_gaveta_pilhas.png
