igorpdsantos/alimentador-pet-iot/site/img/pecas/P12_pata_FD.png

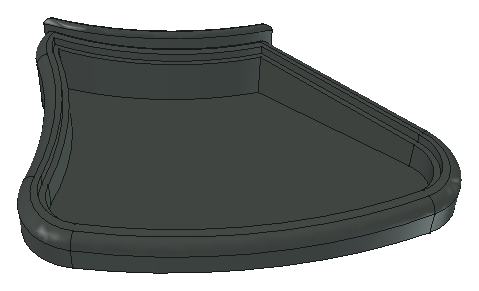
site/img/pecas/P12_pata_FD.png
