igorpdsantos/alimentador-pet-iot/site/img/pecas/P12_pata_FE.png

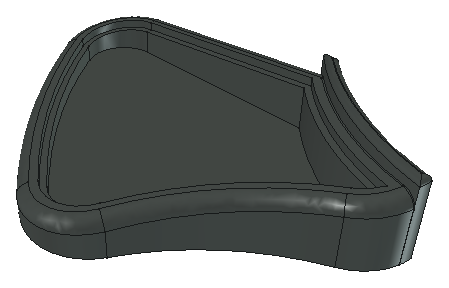
site/img/pecas/P12_pata_FE.png
