igorpdsantos/alimentador-pet-iot/site/img/pecas/P12_pata_TD.png

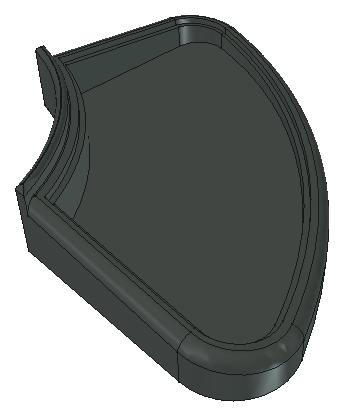
site/img/pecas/P12_pata_TD.png
