igorpdsantos/alimentador-pet-iot/site/img/pecas/P12_pata_TE.png

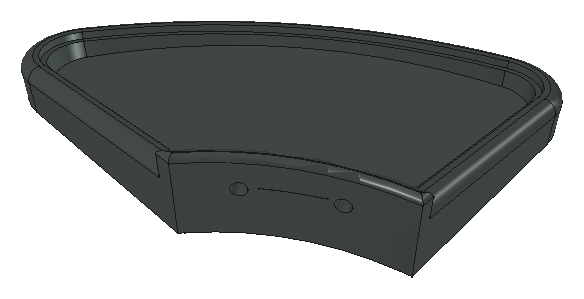
site/img/pecas/P12_pata_TE.png
