igorpdsantos/alimentador-pet-iot/site/img/pecas/P13_tampa_FD.png

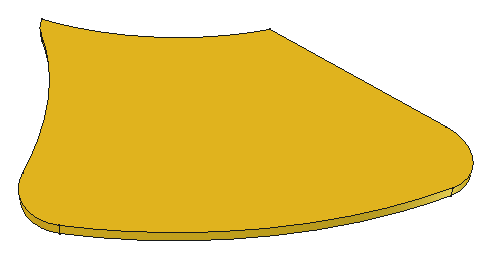
site/img/pecas/P13_tampa_FD.png
