igorpdsantos/alimentador-pet-iot/site/img/pecas/P13_tampa_FE.png

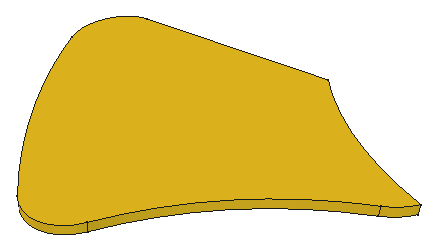
site/img/pecas/P13_tampa_FE.png
