igorpdsantos/alimentador-pet-iot/site/img/pecas/P13_tampa_TD.png

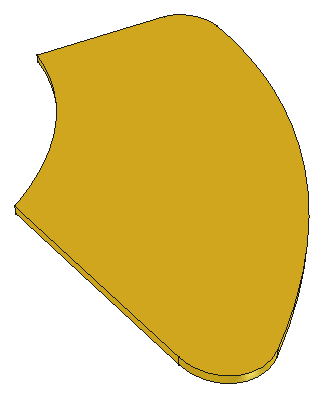
site/img/pecas/P13_tampa_TD.png
