igorpdsantos/alimentador-pet-iot/site/img/pecas/P13_tampa_TE.png

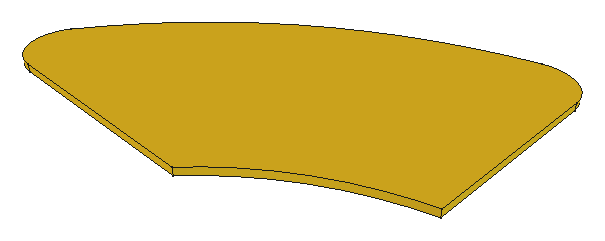
site/img/pecas/P13_tampa_TE.png
