igorpdsantos/alimentador-pet-iot/site/img/pedestal.png

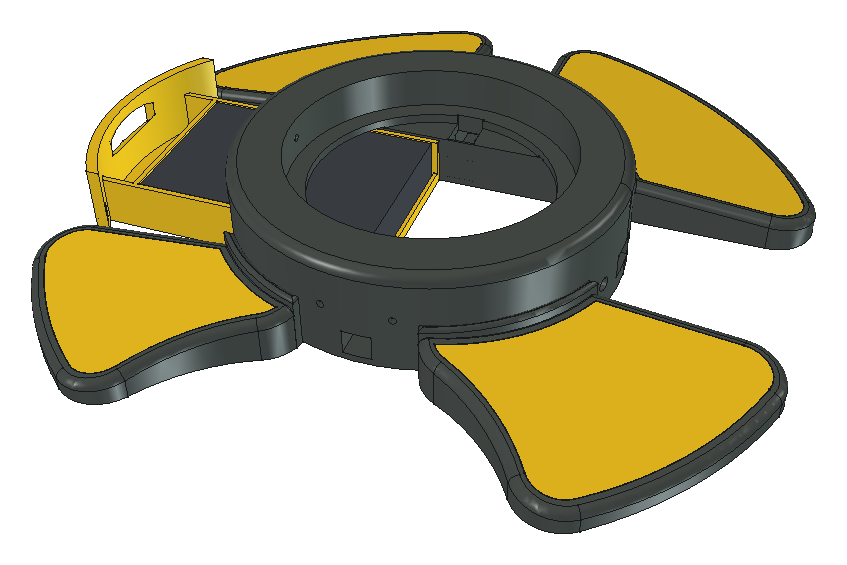
site/img/pedestal.png
