igorpdsantos/alimentador-pet-iot/cad/historico/v2/impressao/P09_tampa_traseira.3mf

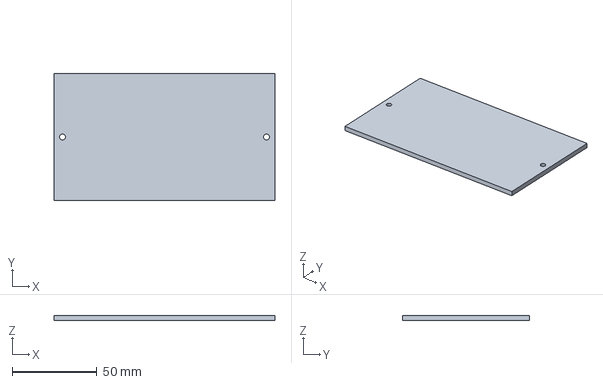
[picture p79: CAD file, 2026-10-14]
cad/historico/v2/impressao/P09_tampa_traseira.3mf
130.0 x 75.0 x 3.00 mm
