igorpdsantos/alimentador-pet-iot/cad/historico/v2/IoT3D_v2.FCStd

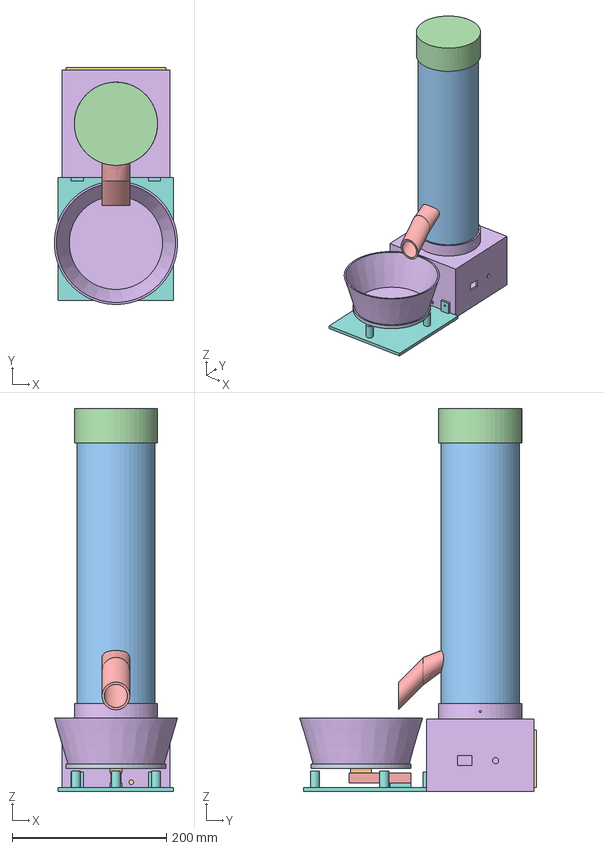
[picture p80: CAD file, 2026-10-14]
cad/historico/v2/IoT3D_v2.FCStd
159.8 x 307.5 x 497.0 mm
P01_superficie_inclinada_45
P03_tampa_atuador_agitador
P04_suporte_motor
P05_funil
P06_extensao_funil_longa
P08_caixa_eletronica
P09_tampa_traseira
P10_base_balanca
P11_plataforma
P12_espacador_plataforma
REF_tubo_PVC_DN100
REF_cap_superior
REF_celula_5kg
REF_vasilha_maior
P02_calco_180
P02_calco_090
P02_calco_270
