igorpdsantos/alimentador-pet-iot/cad/impressao_v3/P07_base_balanca.3mf

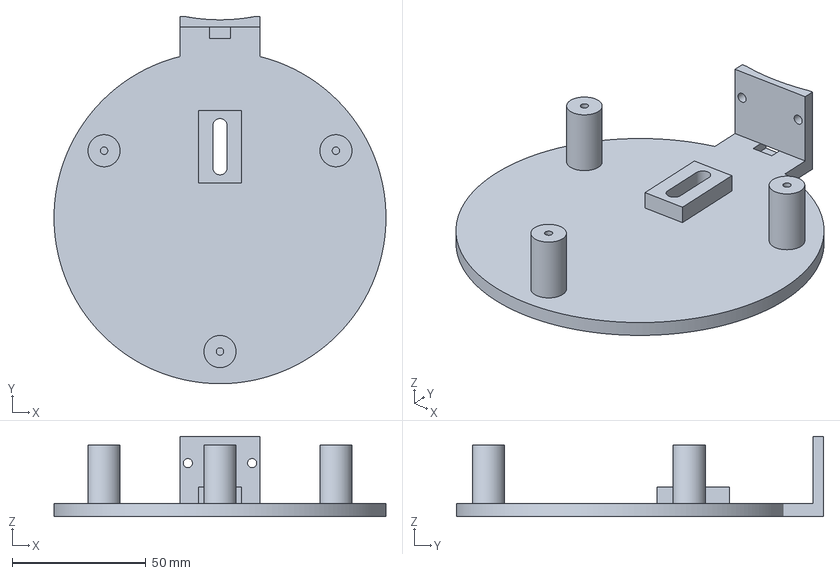
[picture p81: CAD file, 2026-10-14]
cad/impressao_v3/P07_base_balanca.3mf
124.0 x 137.2 x 30.0 mm
