igorpdsantos/alimentador-pet-iot/cad/IoT3D_v3.FCStd

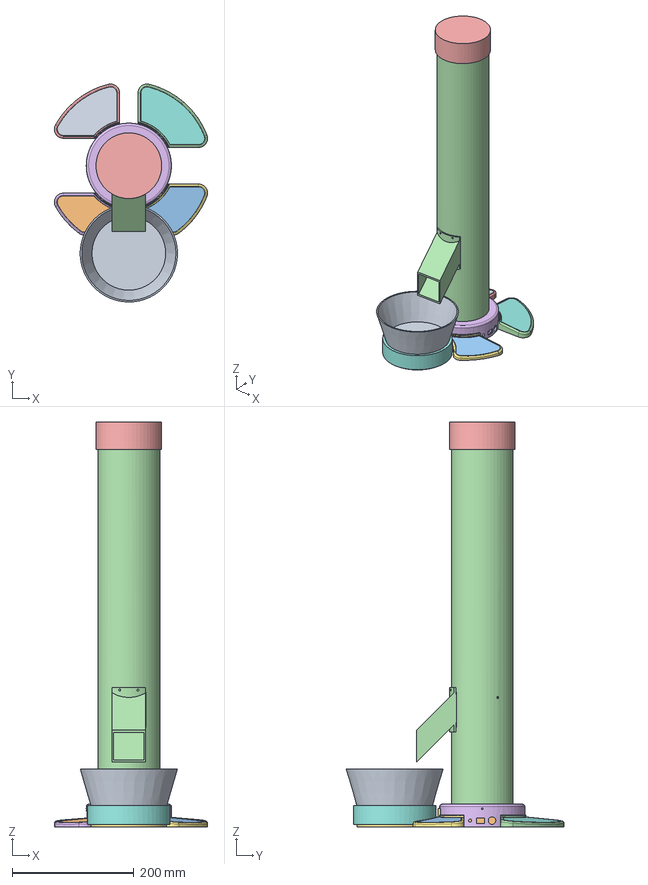
[picture p82: CAD file, 2026-10-14]
cad/IoT3D_v3.FCStd
251.8 x 358.2 x 665.5 mm
P01_piso_dosador
P02_anel_escudo
P03_rotor
P04_bica
P05_bandeja_espinha
P06_pedestal
P07_base_balanca
P08_plataforma
P09_espacador
P10_chapeu
P11_gaveta_pilhas
P12_pata_TD
P12_pata_TE
P12_pata_FE
P12_pata_FD
P13_tampa_TD
P13_tampa_TE
P13_tampa_FE
P13_tampa_FD
REF_tubo_PVC_DN100
REF_cap_superior
REF_servo_MG90S_360
REF_braco_servo
REF_celula_5kg
REF_vasilha_maior
REF_pilhas_6AA
REF_imas_6x2_gaveta
REF_protoboard_ESP32_modulos
