igorpdsantos/alimentador-pet-iot/cad/montagem/IoT3D_v3_montagem.FCStd

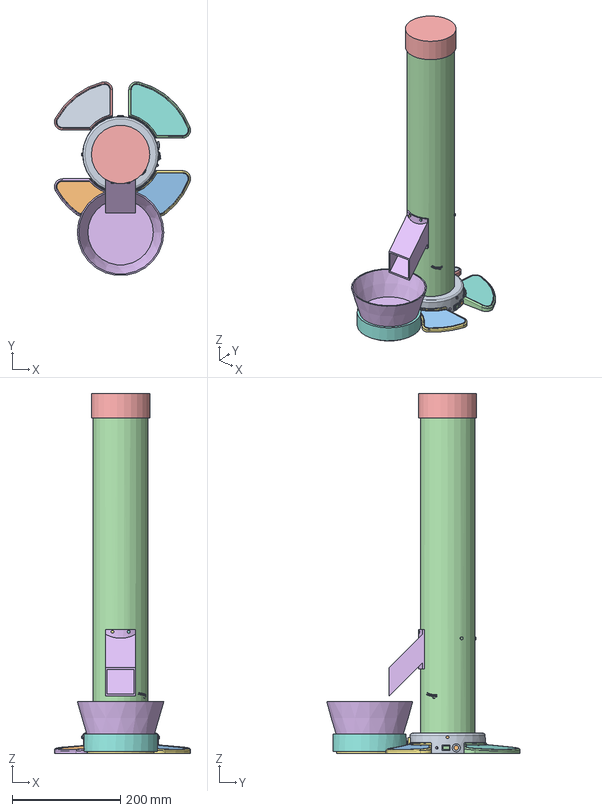
[picture p83: CAD file, 2026-10-14]
cad/montagem/IoT3D_v3_montagem.FCStd
251.8 x 357.7 x 665.5 mm
P06_pedestal
P05_bandeja_espinha
P01_piso_dosador
P02_anel_escudo
P03_rotor
P04_bica
P07_base_balanca
P08_plataforma
P09_espacador
P10_chapeu
P11_gaveta_pilhas
P12_pata_TD
P12_pata_TE
P12_pata_FE
P12_pata_FD
P13_tampa_TD
P13_tampa_TE
P13_tampa_FE
P13_tampa_FD
Tubo_PVC_DN100
Cap_superior
Vasilha_inox
Imas_neodimio_6x2_gaveta
Suporte_6xAA
Pilha_AA_1
Pilha_AA_1_faixa
Pilha_AA_1_polo
Pilha_AA_2
Pilha_AA_2_faixa
Pilha_AA_2_polo
Pilha_AA_3
Pilha_AA_3_faixa
Pilha_AA_3_polo
Pilha_AA_4
Pilha_AA_4_faixa
Pilha_AA_4_polo
Pilha_AA_5
Pilha_AA_5_faixa
Pilha_AA_5_polo
Pilha_AA_6
Pilha_AA_6_faixa
Pilha_AA_6_polo
Jack_P4_rosca
Jack_P4_flange
Jack_P4_porca
Jack_P4_corpo
Jack_P4_terminal_0
Jack_P4_terminal_1
Jack_P4_terminal_2
Chave_KCD11_corpo
Chave_KCD11_moldura
Chave_KCD11_gangorra
Chave_KCD11_marca_I
Chave_KCD11_terminal_0
Chave_KCD11_terminal_1
Botao_rosca
Botao_cabeca
Botao_atuador
Botao_porca
Botao_terminal_0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
