igorpdsantos/alimentador-pet-iot/site/arquivos/pecas/P01_piso_dosador.3mf

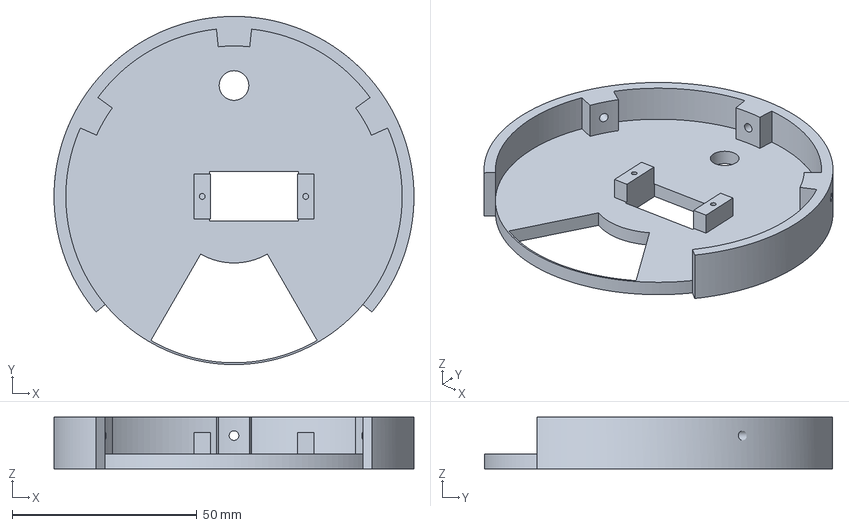
[picture p84: CAD file, 2026-10-14]
site/arquivos/pecas/P01_piso_dosador.3mf
97.4 x 94.2 x 14.0 mm
