igorpdsantos/alimentador-pet-iot/cad/historico/v2/impressao/P02_calco_270.3mf

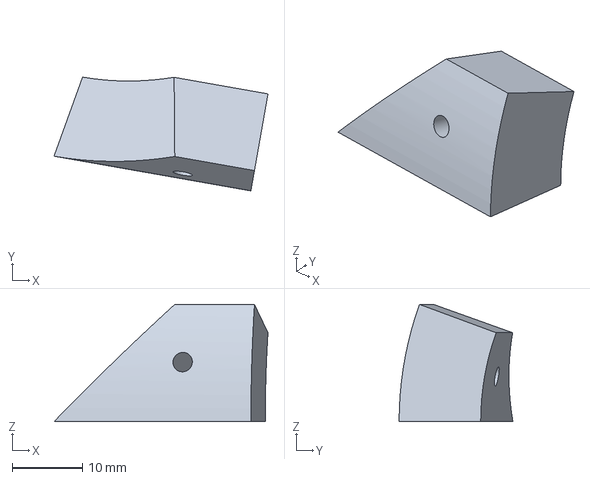
[picture p85: CAD file, 2026-10-14]
cad/historico/v2/impressao/P02_calco_270.3mf
30.5 x 16.2 x 16.7 mm
