igorpdsantos/alimentador-pet-iot/site/arquivos/pecas/P13_tampa_FE.3mf

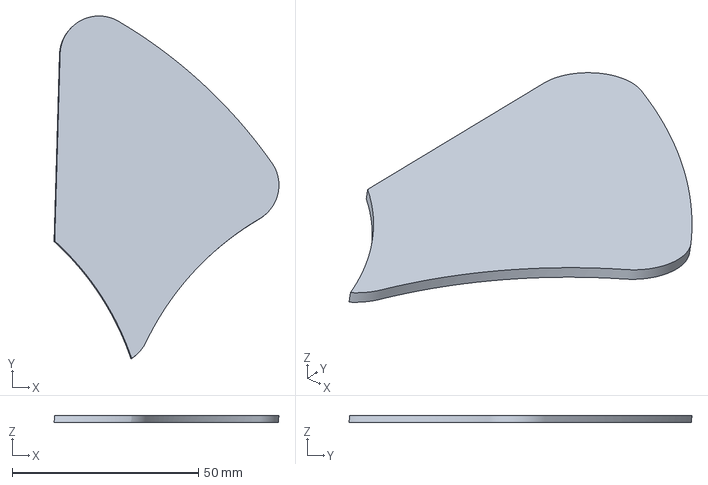
[picture p86: CAD file, 2026-10-14]
site/arquivos/pecas/P13_tampa_FE.3mf
60.3 x 92.0 x 1.98 mm
