igorpdsantos/alimentador-pet-iot/cad/impressao_v3/P11_gaveta_pilhas.3mf

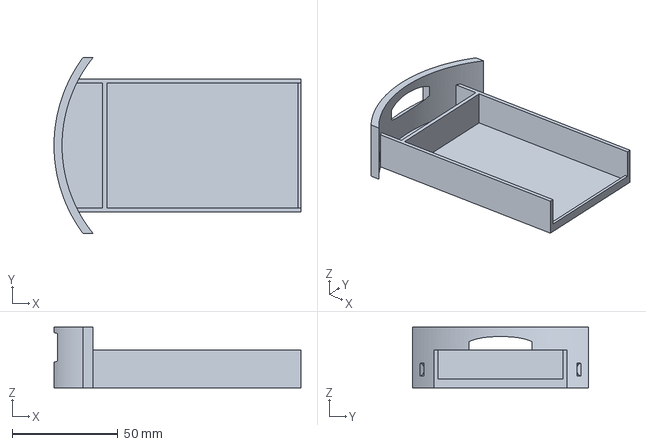
[picture p87: CAD file, 2026-10-14]
cad/impressao_v3/P11_gaveta_pilhas.3mf
116.7 x 83.0 x 28.8 mm
