igorpdsantos/alimentador-pet-iot/site/arquivos/pecas/P12_pata_TE.3mf

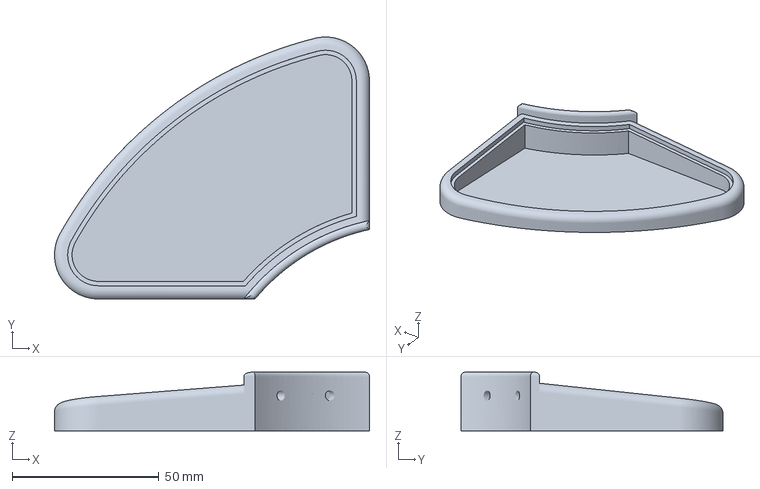
[picture p88: CAD file, 2026-10-14]
site/arquivos/pecas/P12_pata_TE.3mf
107.4 x 89.3 x 20.0 mm
