igorpdsantos/alimentador-pet-iot/cad/historico/v2/impressao/P12_espacador_plataforma.3mf

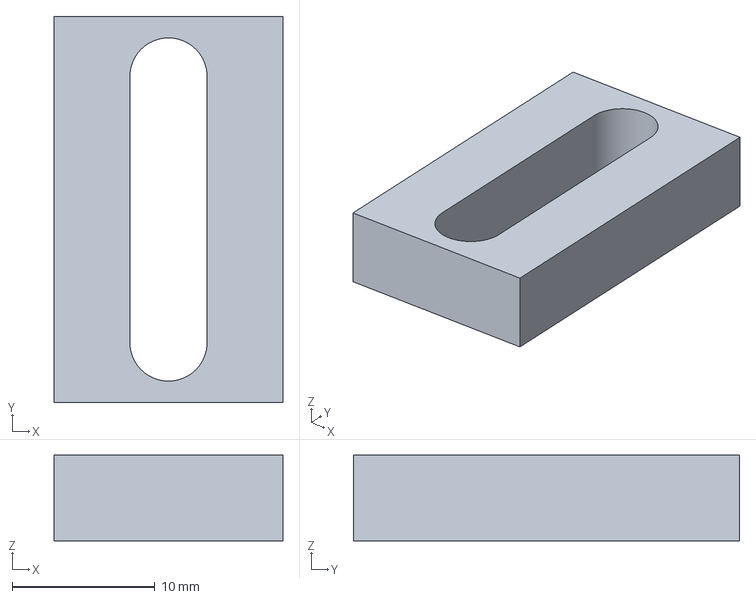
[picture p89: CAD file, 2026-10-14]
cad/historico/v2/impressao/P12_espacador_plataforma.3mf
16.0 x 27.0 x 6.00 mm
