igorpdsantos/alimentador-pet-iot/cad/impressao_v3/P13_tampa_TD.3mf

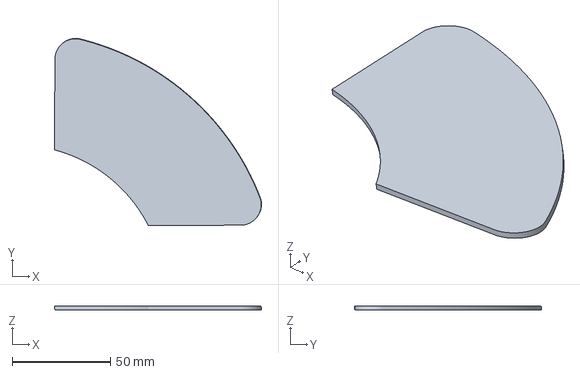
[picture p90: CAD file, 2026-10-14]
cad/impressao_v3/P13_tampa_TD.3mf
105.5 x 95.4 x 1.98 mm
