igorpdsantos/alimentador-pet-iot/cad/historico/v2/impressao/P10_base_balanca.3mf

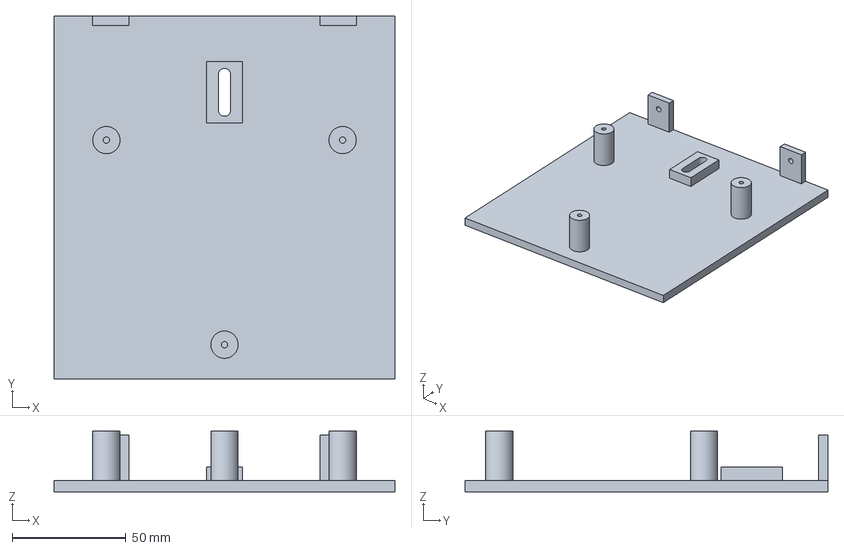
[picture p91: CAD file, 2026-10-14]
cad/historico/v2/impressao/P10_base_balanca.3mf
150.0 x 159.5 x 26.7 mm
