igorpdsantos/alimentador-pet-iot/cad/impressao_v3/P02_anel_escudo.3mf

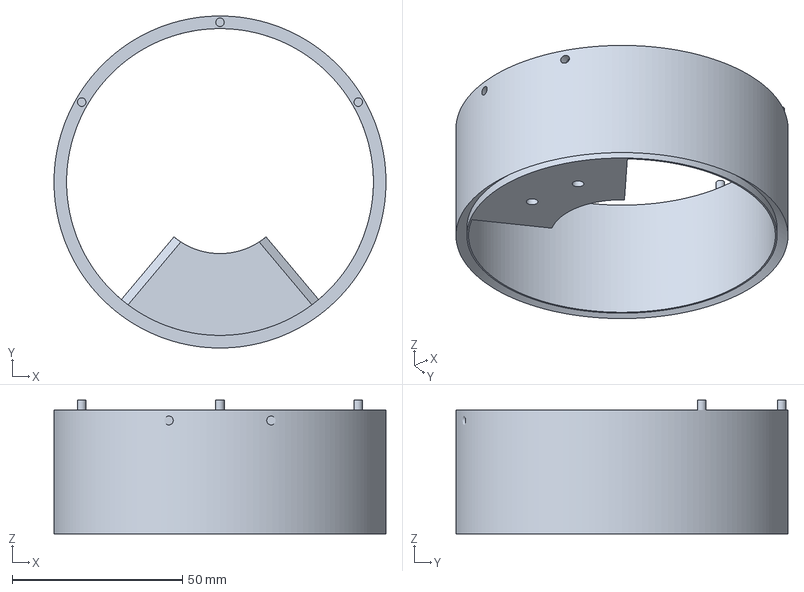
[picture p92: CAD file, 2026-10-14]
cad/impressao_v3/P02_anel_escudo.3mf
97.4 x 97.4 x 39.3 mm
