igorpdsantos/alimentador-pet-iot/site/arquivos/pecas/P13_tampa_FD.3mf

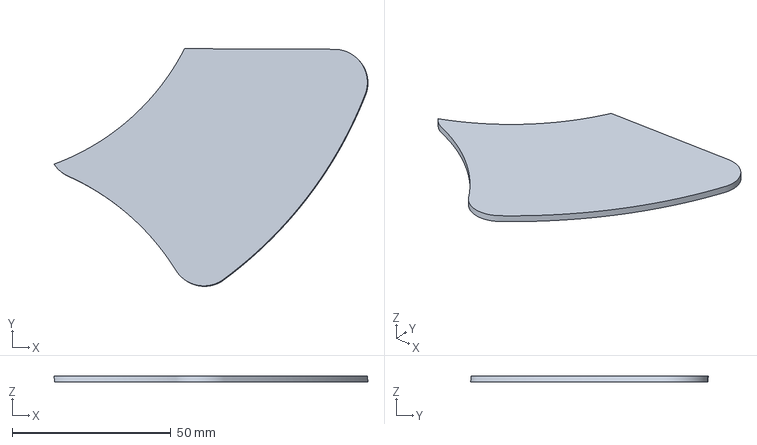
[picture p93: CAD file, 2026-10-14]
site/arquivos/pecas/P13_tampa_FD.3mf
98.9 x 74.9 x 1.98 mm
