igorpdsantos/alimentador-pet-iot/cad/historico/v2/impressao/P04_suporte_motor.3mf

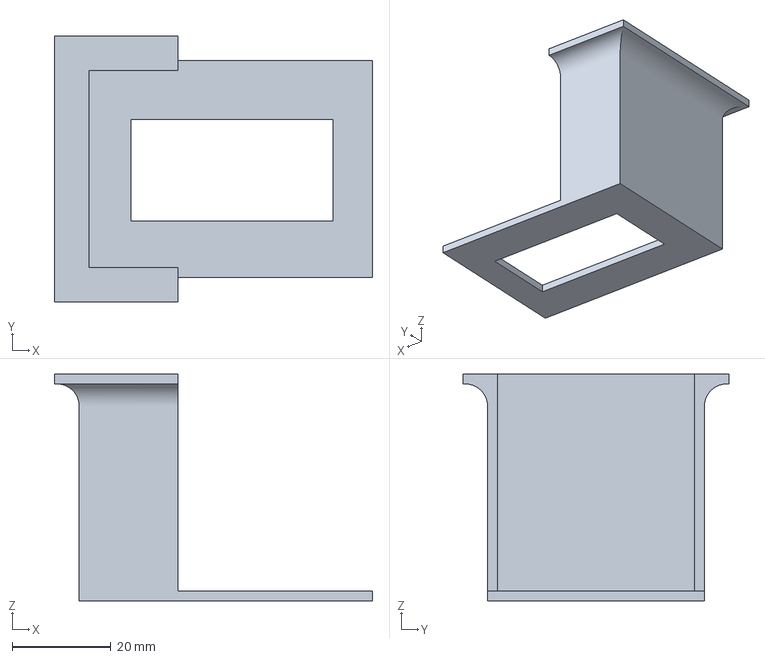
[picture p94: CAD file, 2026-10-14]
cad/historico/v2/impressao/P04_suporte_motor.3mf
64.5 x 54.0 x 46.0 mm
