igorpdsantos/alimentador-pet-iot/cad/impressao_v3/P04_bica.3mf

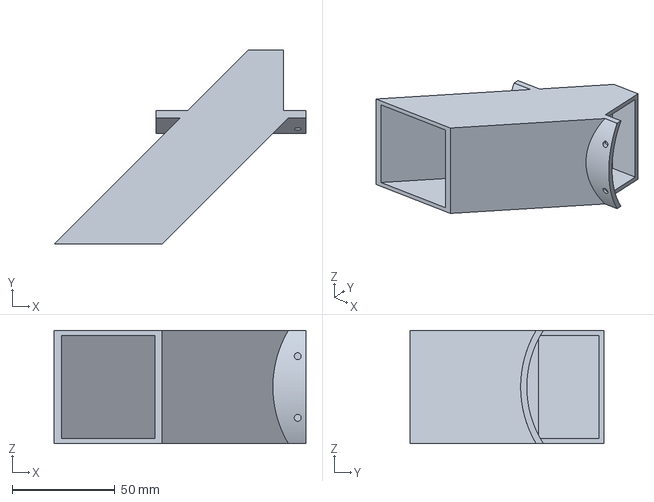
[picture p95: CAD file, 2026-10-14]
cad/impressao_v3/P04_bica.3mf
122.6 x 94.5 x 55.0 mm
