igorpdsantos/alimentador-pet-iot/site/arquivos/pecas/P08_plataforma.3mf

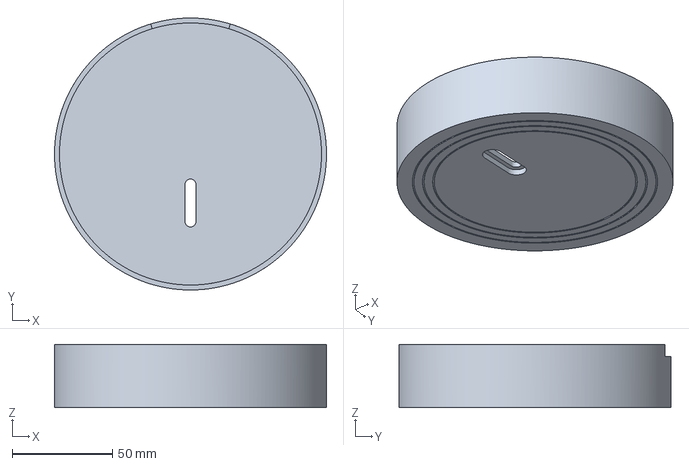
[picture p96: CAD file, 2026-10-14]
site/arquivos/pecas/P08_plataforma.3mf
136.0 x 136.0 x 31.7 mm
