igorpdsantos/alimentador-pet-iot/cad/historico/v2/impressao/P02_calco_180.3mf

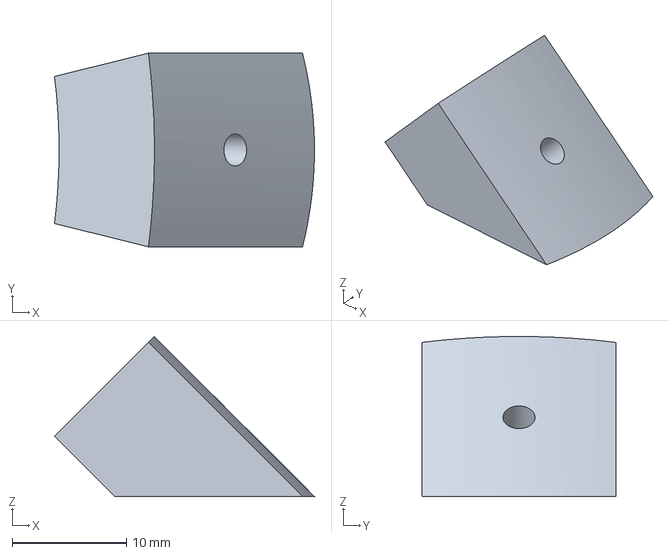
[picture p97: CAD file, 2026-10-14]
cad/historico/v2/impressao/P02_calco_180.3mf
22.7 x 16.9 x 14.0 mm
