igorpdsantos/alimentador-pet-iot/cad/historico/v2/impressao/P06_extensao_funil_longa.3mf

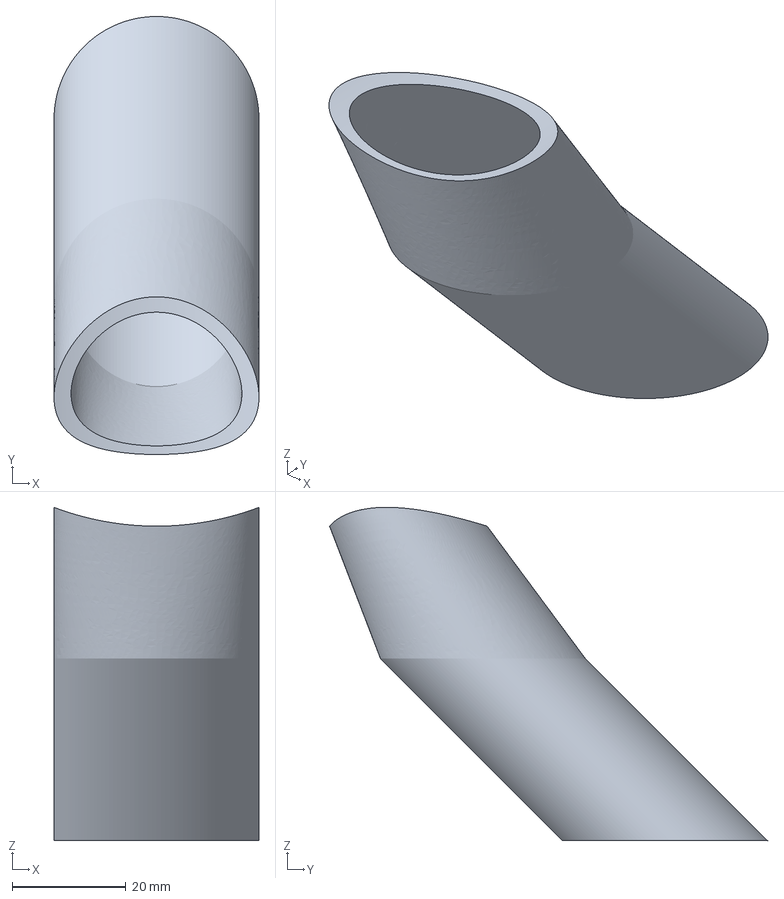
[picture p98: CAD file, 2026-10-14]
cad/historico/v2/impressao/P06_extensao_funil_longa.3mf
36.0 x 76.9 x 58.5 mm
