igorpdsantos/alimentador-pet-iot/site/arquivos/pecas/P13_tampa_TE.3mf

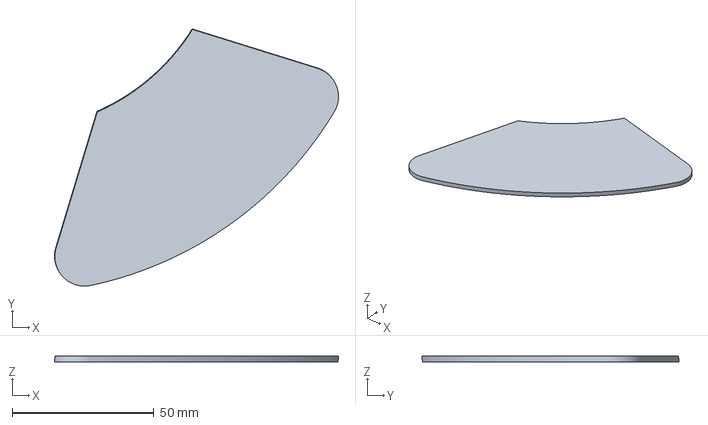
[picture p99: CAD file, 2026-10-14]
site/arquivos/pecas/P13_tampa_TE.3mf
100.2 x 90.8 x 1.98 mm
