igorpdsantos/alimentador-pet-iot/cad/historico/v2/impressao/P05_funil.3mf

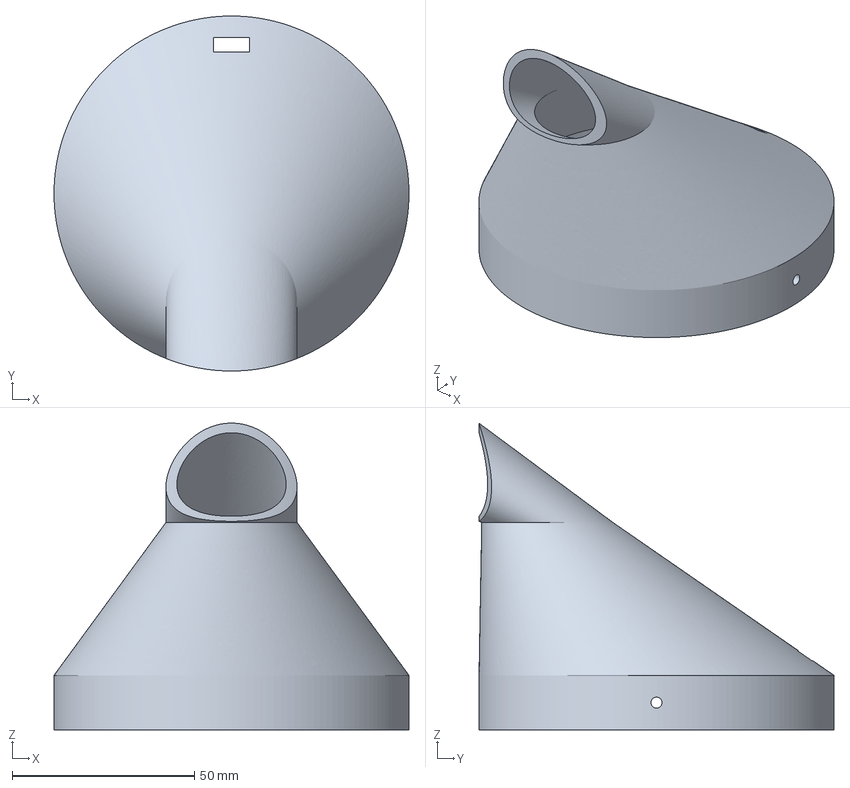
[picture p100: CAD file, 2026-10-14]
cad/historico/v2/impressao/P05_funil.3mf
97.5 x 97.5 x 84.3 mm
