igorpdsantos/alimentador-pet-iot/site/arquivos/pecas/P12_pata_TD.3mf

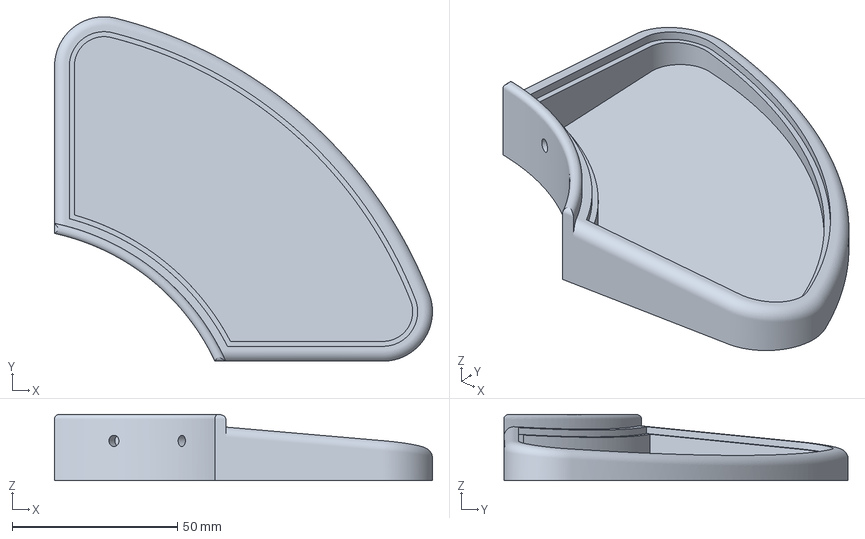
[picture p101: CAD file, 2026-10-14]
site/arquivos/pecas/P12_pata_TD.3mf
114.5 x 104.3 x 20.0 mm
