igorpdsantos/alimentador-pet-iot/cad/historico/v2/impressao/P11_plataforma.3mf

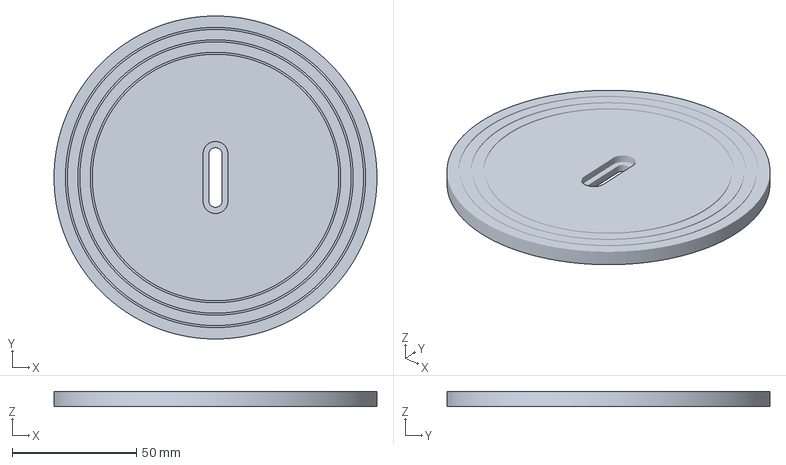
[picture p102: CAD file, 2026-10-14]
cad/historico/v2/impressao/P11_plataforma.3mf
130.0 x 130.0 x 6.00 mm
