igorpdsantos/alimentador-pet-iot/cad/impressao_v3/P12_pata_FE.3mf

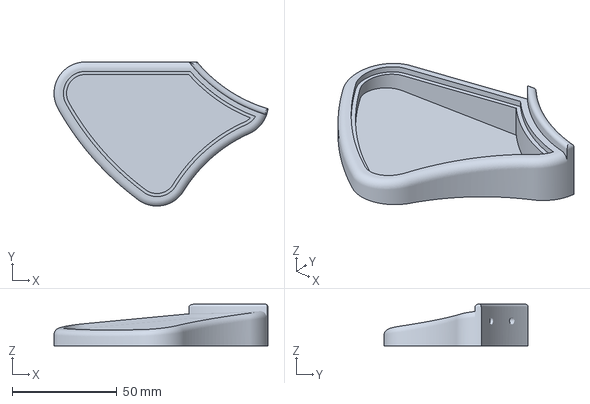
[picture p103: CAD file, 2026-10-14]
cad/impressao_v3/P12_pata_FE.3mf
102.3 x 68.9 x 20.0 mm
