igorpdsantos/alimentador-pet-iot/site/arquivos/pecas/P05_bandeja_espinha.3mf

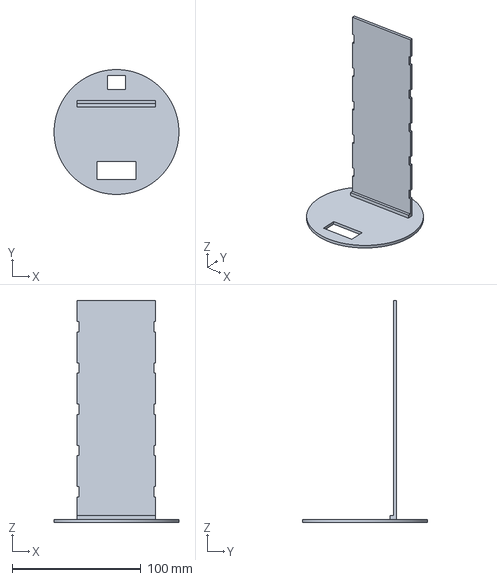
[picture p104: CAD file, 2026-10-14]
site/arquivos/pecas/P05_bandeja_espinha.3mf
97.0 x 97.0 x 172.5 mm
