igorpdsantos/alimentador-pet-iot/cad/historico/v2/impressao/P01_superficie_inclinada_45.3mf

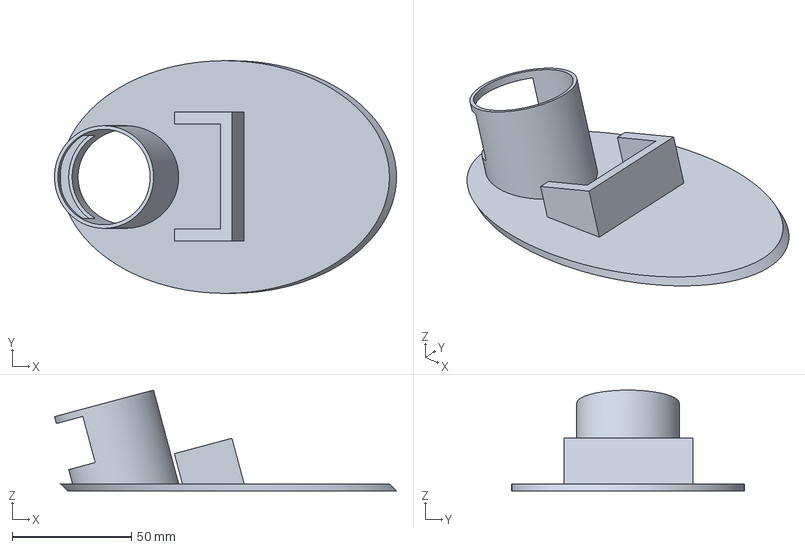
[picture p105: CAD file, 2026-10-14]
cad/historico/v2/impressao/P01_superficie_inclinada_45.3mf
143.4 x 97.5 x 42.3 mm
