igorpdsantos/alimentador-pet-iot/cad/historico/v2/impressao/P08_caixa_eletronica.3mf

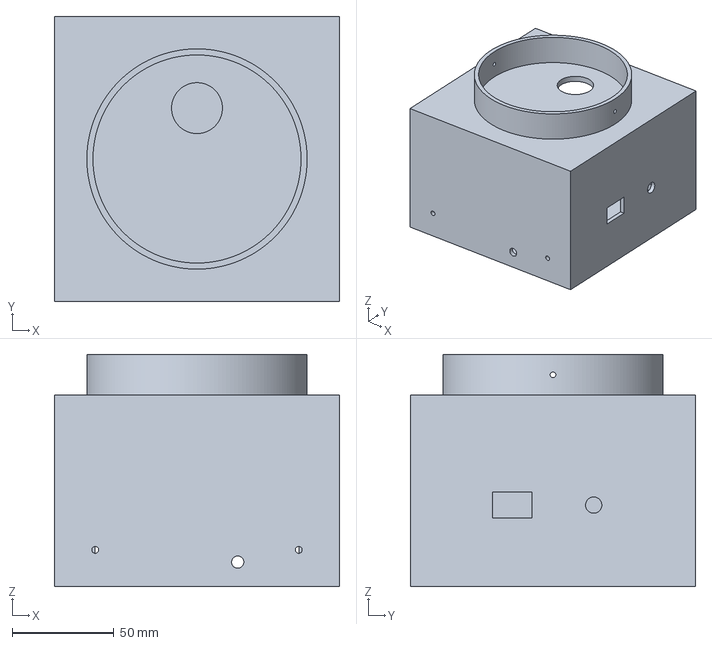
[picture p106: CAD file, 2026-10-14]
cad/historico/v2/impressao/P08_caixa_eletronica.3mf
140.0 x 140.0 x 114.0 mm
