igorpdsantos/alimentador-pet-iot/cad/historico/v2/impressao/P03_tampa_atuador_agitador.3mf

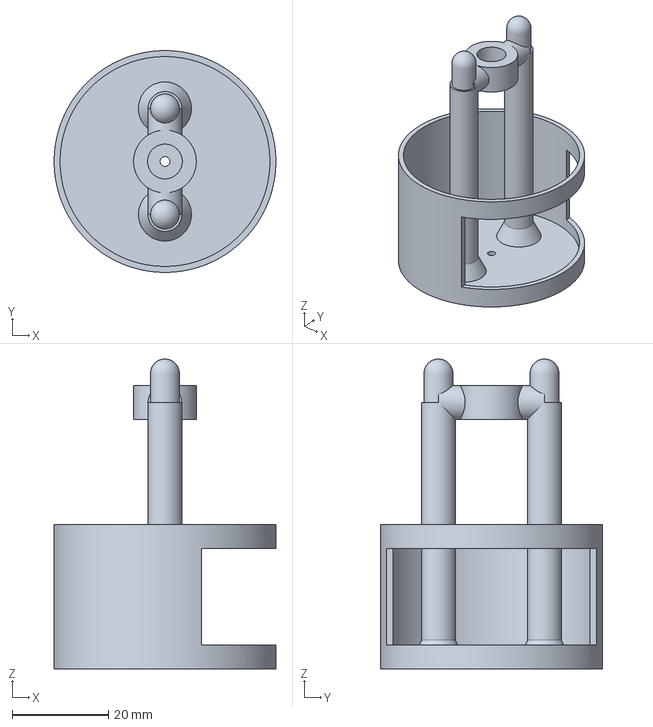
[picture p107: CAD file, 2026-10-14]
cad/historico/v2/impressao/P03_tampa_atuador_agitador.3mf
46.0 x 46.0 x 64.3 mm
