igorpdsantos/alimentador-pet-iot/cad/impressao_v3/P03_rotor.3mf

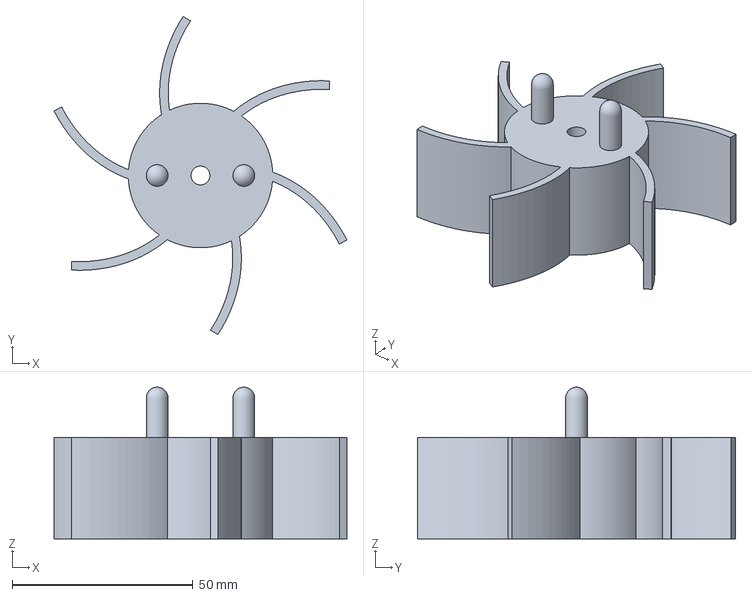
[picture p108: CAD file, 2026-10-14]
cad/impressao_v3/P03_rotor.3mf
81.1 x 88.1 x 42.0 mm
