igorpdsantos/alimentador-pet-iot/site/arquivos/pecas/P12_pata_FD.3mf

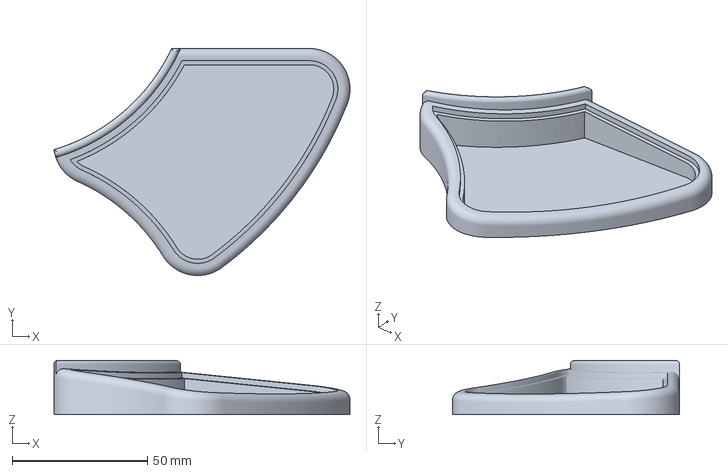
[picture p109: CAD file, 2026-10-14]
site/arquivos/pecas/P12_pata_FD.3mf
109.3 x 83.8 x 20.0 mm
