igorpdsantos/alimentador-pet-iot/cad/impressao_v3/P06_pedestal.3mf

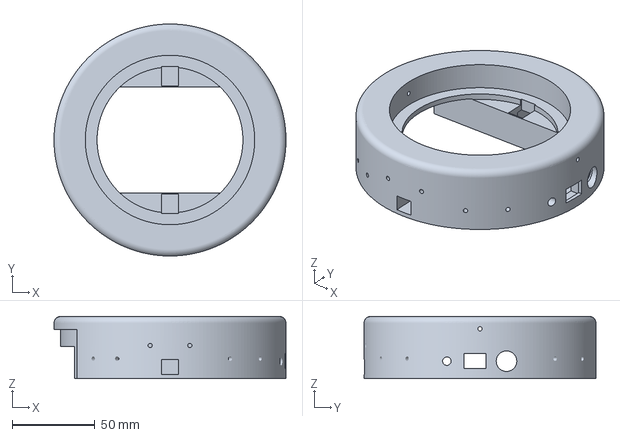
[picture p110: CAD file, 2026-10-14]
cad/impressao_v3/P06_pedestal.3mf
140.0 x 140.0 x 37.5 mm
