igorpdsantos/alimentador-pet-iot/site/arquivos/pecas/P10_chapeu.3mf

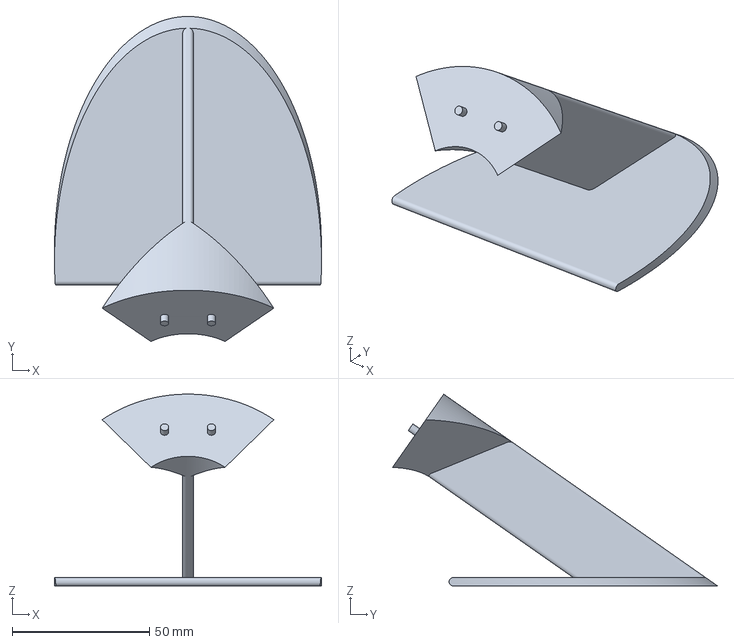
[picture p111: CAD file, 2026-10-14]
site/arquivos/pecas/P10_chapeu.3mf
97.4 x 118.6 x 69.9 mm
