igorpdsantos/alimentador-pet-iot/(list of files, cad)

Other CAD files:
site/arquivos/alimentador_v3.step
cad/historico/v2/impressao/P02_calco_090.3mf
site/arquivos/pecas/P09_espacador.3mf
cad/impressao_v3/P09_espacador.3mf
cad/historico/v1/IoT3D-Funil_interno.stl
cad/historico/v1/IoT3D-PartSuporte_motor.stl
cad/historico/v1/IoT3D-PartSuporte_placa_eletronica.stl
cad/historico/v1/IoT3D-PartSuporte_superficie_inclinada.stl
cad/historico/v1/IoT3D-Partsuperficie_inclinada.stl
cad/historico/v1/IoT3D-Parttampa_atuador.stl
cad/historico/v1/IoT3D-completo.stl
cad/historico/v1/IoT3D-extensao_funil.stl
cad/historico/v1/IoT3D.FCStd
cad/historico/v2/impressao/P01_superficie_inclinada_45.stl
cad/historico/v2/impressao/P02_calco_090.stl
cad/historico/v2/impressao/P02_calco_180.stl
cad/historico/v2/impressao/P02_calco_270.stl
cad/historico/v2/impressao/P03_tampa_atuador_agitador.stl
cad/historico/v2/impressao/P04_suporte_motor.stl
cad/historico/v2/impressao/P05_funil.stl
cad/historico/v2/impressao/P06_extensao_funil_longa.stl
cad/historico/v2/impressao/P08_caixa_eletronica.stl
cad/historico/v2/impressao/P09_tampa_traseira.stl
cad/historico/v2/impressao/P10_base_balanca.stl
cad/historico/v2/impressao/P11_plataforma.stl
cad/historico/v2/impressao/P12_espacador_plataforma.stl
cad/impressao_v3/P01_piso_dosador.stl
cad/impressao_v3/P02_anel_escudo.stl
cad/impressao_v3/P03_rotor.stl
cad/impressao_v3/P04_bica.stl
cad/impressao_v3/P05_bandeja_espinha.stl
cad/impressao_v3/P06_pedestal.stl
cad/impressao_v3/P07_base_balanca.stl
cad/impressao_v3/P08_plataforma.stl
cad/impressao_v3/P09_espacador.stl
cad/impressao_v3/P10_chapeu.stl
cad/impressao_v3/P11_gaveta_pilhas.stl
cad/impressao_v3/P12_pata_FD.stl
cad/impressao_v3/P12_pata_FE.stl
cad/impressao_v3/P12_pata_TD.stl
cad/impressao_v3/P12_pata_TE.stl
cad/impressao_v3/P13_tampa_FD.stl
cad/impressao_v3/P13_tampa_FE.stl
cad/impressao_v3/P13_tampa_TD.stl
cad/impressao_v3/P13_tampa_TE.stl
site/arquivos/pecas/P01_piso_dosador.stl
site/arquivos/pecas/P02_anel_escudo.stl
site/arquivos/pecas/P03_rotor.stl
site/arquivos/pecas/P04_bica.stl
site/arquivos/pecas/P05_bandeja_espinha.stl
site/arquivos/pecas/P06_pedestal.stl
site/arquivos/pecas/P07_base_balanca.stl
site/arquivos/pecas/P08_plataforma.stl
site/arquivos/pecas/P09_espacador.stl
site/arquivos/pecas/P10_chapeu.stl
site/arquivos/pecas/P11_gaveta_pilhas.stl
site/arquivos/pecas/P12_pata_FD.stl
site/arquivos/pecas/P12_pata_FE.stl
site/arquivos/pecas/P12_pata_TD.stl
site/arquivos/pecas/P12_pata_TE.stl
site/arquivos/pecas/P13_tampa_FD.stl
site/arquivos/pecas/P13_tampa_FE.stl
site/arquivos/pecas/P13_tampa_TD.stl
site/arquivos/pecas/P13_tampa_TE.stl
