igorpdsantos/alimentador-pet-iot/cad/montagem/texturas/esp32_baixo.png

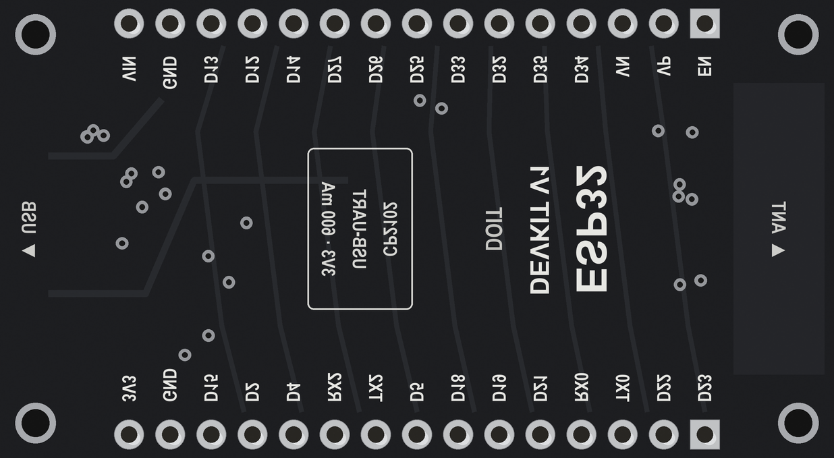
cad/montagem/texturas/esp32_baixo.png
