igorpdsantos/alimentador-pet-iot/cad/montagem/texturas/esquematicas/esp32_baixo.png

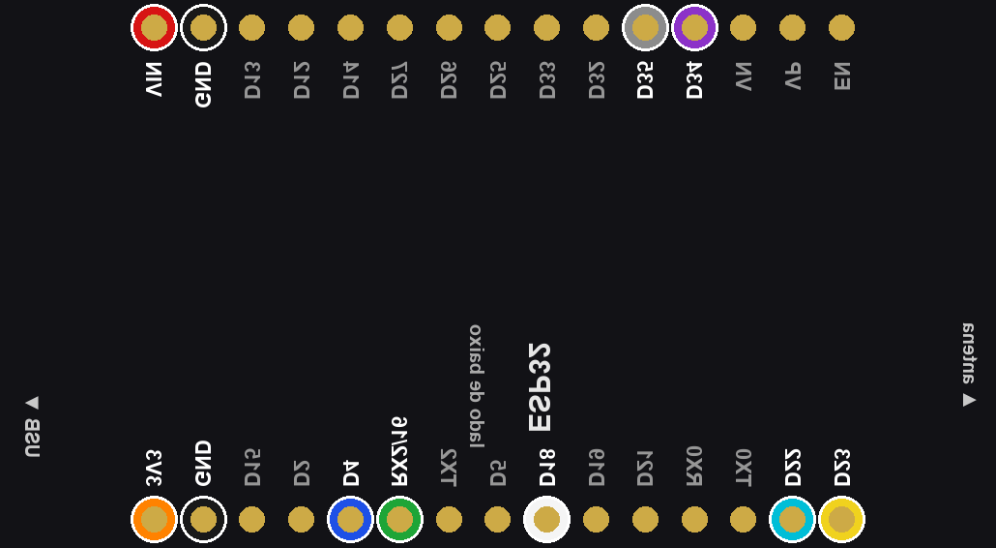
cad/montagem/texturas/esquematicas/esp32_baixo.png
