igorpdsantos/alimentador-pet-iot/cad/montagem/texturas/esquematicas/hx711.png

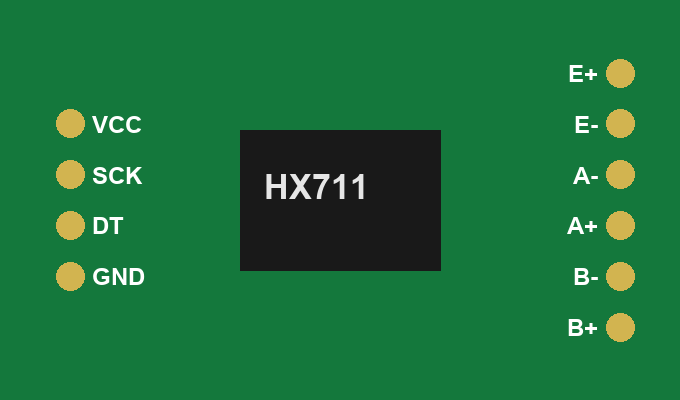
cad/montagem/texturas/esquematicas/hx711.png
