igorpdsantos/alimentador-pet-iot/cad/montagem/texturas/esquematicas/mp1584.png

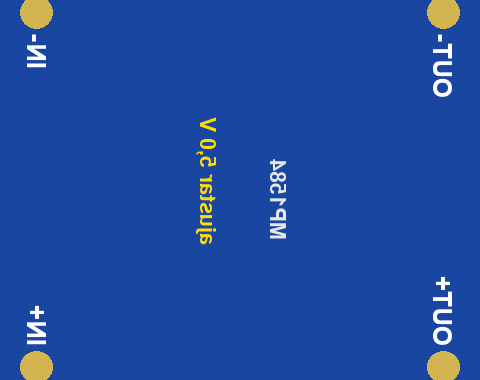
cad/montagem/texturas/esquematicas/mp1584.png
