igorpdsantos/alimentador-pet-iot/cad/montagem/texturas/esquematicas/protoboard.png

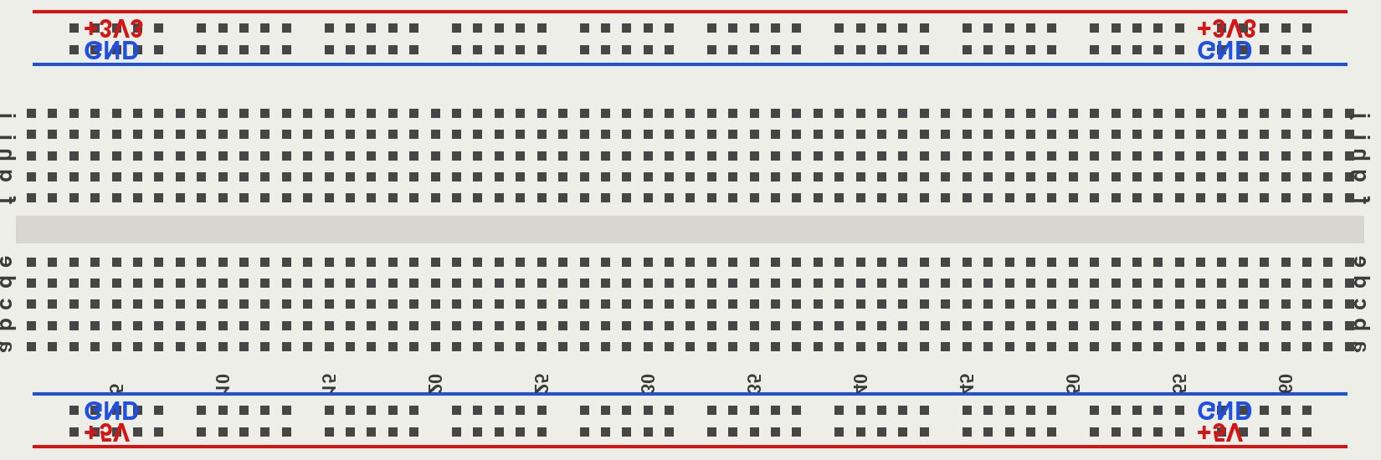
cad/montagem/texturas/esquematicas/protoboard.png
