igorpdsantos/alimentador-pet-iot/cad/montagem/texturas/hx711.png

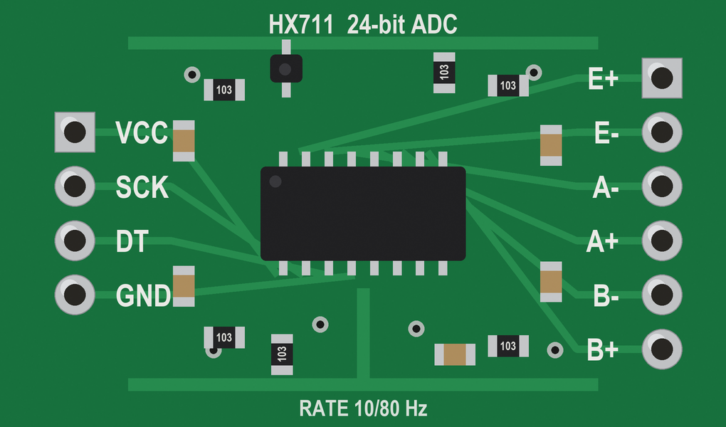
cad/montagem/texturas/hx711.png
