igorpdsantos/alimentador-pet-iot/cad/montagem/texturas/mp1584.png

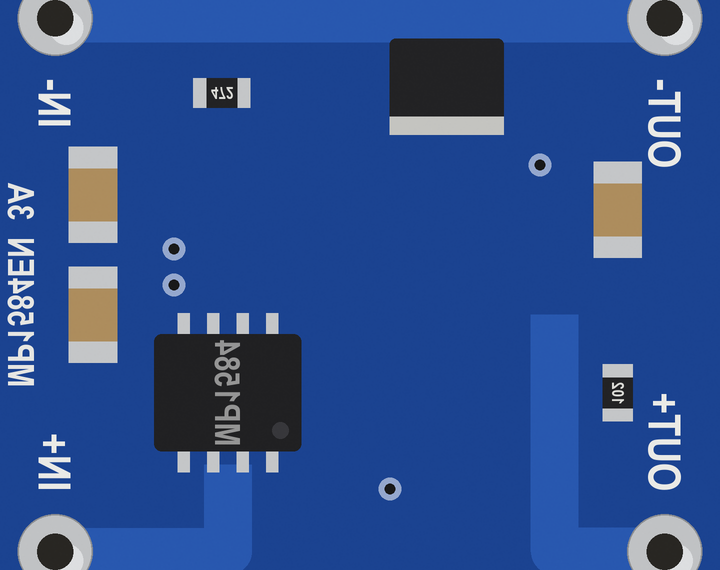
cad/montagem/texturas/mp1584.png
