igorpdsantos/alimentador-pet-iot/cad/montagem/texturas/protoboard.png

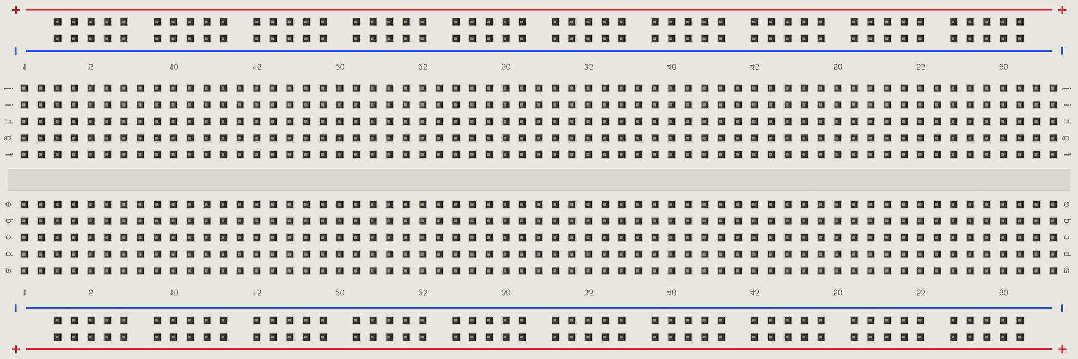
cad/montagem/texturas/protoboard.png
