igorpdsantos/alimentador-pet-iot/cad/montagem/texturas/web/esp32_baixo.jpg

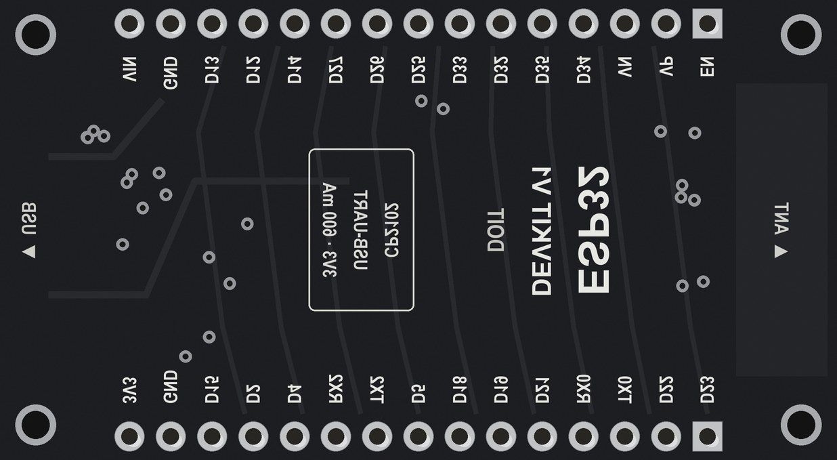
cad/montagem/texturas/web/esp32_baixo.jpg
