igorpdsantos/alimentador-pet-iot/cad/montagem/texturas/web/protoboard.jpg

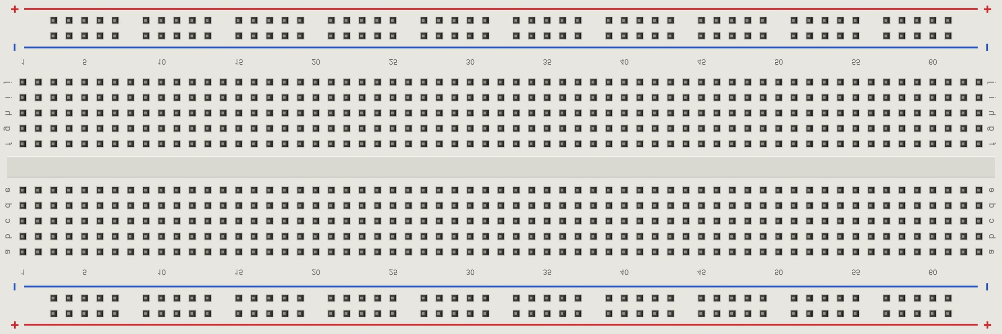
cad/montagem/texturas/web/protoboard.jpg
