igorpdsantos/alimentador-pet-iot/site/img/montagem.png

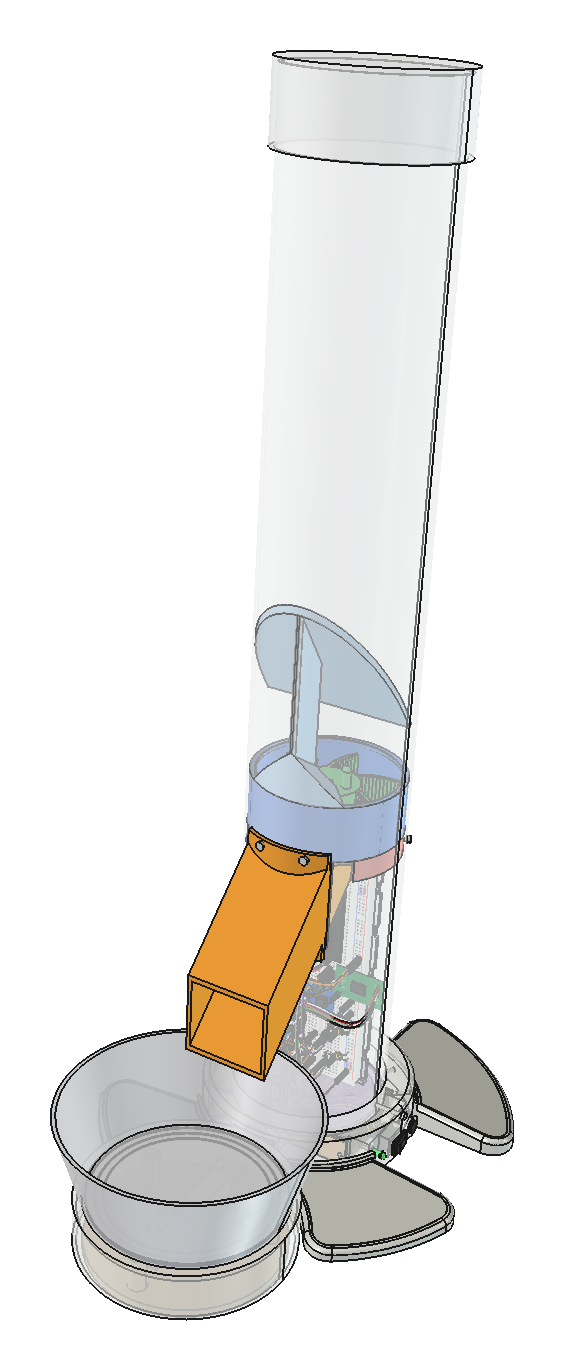
site/img/montagem.png
