igorpdsantos/alimentador-pet-iot/firmware/include/ca_cert.h

// Certificado raiz do HiveMQ Cloud (ISRG Root X1, Let's Encrypt), válido até 04/06/2035.
// Fonte: https://letsencrypt.org/certs/isrgrootx1.pem
#pragma once

static const char CA_CERT[] PROGMEM = R"PEM(
-----BEGIN CERTIFICATE-----
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
-----END CERTIFICATE-----
)PEM";
