igorpdsantos/alimentador-pet-iot/(commit log)

2026-10-14 Primeira versão pública do Alimentador de Pet IoT
    Modelo 3D v3 (FreeCAD, STL/3MF para imprimir, montagem detalhada), specs,
    documentação de montagem, site estático (GitHub Pages) e simulação DEM do
    dosador. Pastas firmware/ e app/ preparadas com README e exemplos de
    credenciais; código ainda em desenvolvimento.
    [IoT3D-Funil_interno.stl, IoT3D-PartSuporte_motor.stl, IoT3D-PartSuporte_placa_eletronica.stl, IoT3D-PartSuporte_superficie_inclinada.stl, IoT3D-Partsuperficie_inclinada.stl, IoT3D-Parttampa_atuador.stl, IoT3D-completo.stl, IoT3D-extensao_funil.stl]
2026-10-15 Plano de compra avulso e teto de R$ 490
    Orçamento com o plano cotado em 14/10/2026: itens no Mercado Livre,
    Saravati e Mamute (Santa Ifigênia) e parafusos avulsos, com links,
    endereços e preços. Impressão 3D terceirizada (~R$ 188,50) e teto
    revisto para R$ 490 (D12). Site mostra compras + impressão.
2026-10-17 Itens do Mercado Livre no carrinho
    ESP32 DOIT mais barato (R$ 35,28), tubo em outro anúncio (o anterior
    esgotou) e fretes do tubo e dos ímãs. Total no carrinho R$ 152,05.
2026-10-27 Firmware do ESP32, app PWA e simulador
    - firmware/: dosagem por peso em malha fechada, agenda, bateria, reservatório,
    histórico em LittleFS, MQTT com TLS, portal Wi-Fi e OTA. Lógica pura em
    lib/core com 40 testes nativos (pio test -e native).
    - app/: PWA (Vite + React + TypeScript) com pareamento, início, agenda,
    histórico com gráficos, ajustes e calibração da balança. 23 testes (vitest).
    - tools/simulador/: faz o papel do ESP32, com broker MQTT local (--local).
    - tools/protocol-fixtures/: exemplos do contrato usados pelos dois lados.
    - specs: app passa a ser PWA (D19) e lógica do firmware em lib/core (D20).
    [cmd_servo_trim.json]
2026-10-27 Documenta a segurança: acesso pelo broker, exposição na rede e checklist de senhas
2026-10-27 Rede de configuração com senha (D21)
    O portal "Alimentador-xxxxxx" passa a usar WPA2 com PORTAL_PASS (secrets.h,
    8 a 63 caracteres; o firmware não compila fora disso), impressa na etiqueta
    junto do QR. App, specs, docs de montagem, segurança e site atualizados.
